ParadigmEngineering/igvc-2023-hardware/README.md

# igvc-2023-hardware
Intelligent Ground Vehicle Competition (Spring 2023) hardware for the Paradigm Engineering Student Group
