ParadigmEngineering/igvc-2023-hardware/hardware/ControlBoard/ControlBoard_Build_2023_04_23/ControlBoard.csv

Comment | Designator | Footprint | LCSC
1u | C1,C31,C34,C37,C40 | Capacitor_SMD:C_0805_2012Metric | C116352
22uF | C13 | Capacitor_SMD:C_0805_2012Metric | C128856
0.1u_DNP | C15,C16 | Capacitor_SMD:C_0805_2012Metric
10u_DNP | C2,C10 | Capacitor_SMD:C_0805_2012Metric
33uF | C26 | Capacitor_THT:CP_Radial_D8.0mm_P3.50mm | C441625
4.7u | C3 | Capacitor_SMD:C_0805_2012Metric | C87998
10n | C30 | Capacitor_SMD:C_0805_2012Metric | C2688117
10u | C4,C5,C8,C18 | Capacitor_SMD:C_0805_2012Metric | C237493
1uF | C6 | Capacitor_SMD:C_0805_2012Metric | C116352
0.1u | C7,C9,C11,C12,C14,C17,C19,C21,C22,C23,C24,C25,C27,C28,C29,C32,C33,C35,C36,C38,C39 | Capacitor_SMD:C_0805_2012Metric | C519981
SMAJ5.0CA | D1,D4,D6,D7,D8,D10 | Diode_SMD:D_SMA | C83324
S1G | D11 | Diode_SMD:D_SMA | C260339
RED | D2,D3 | LED_SMD:LED_0603_1608Metric | C160478
SL04-E3-08_DNP | D5,D9 | Diode_SMD:D_SMF | C5224083
M3 | H1,H2,H3,H4 | MountingHole:MountingHole_3.2mm_M3_Pad_Via
Lamp 1 Out | J1 | Connector_Molex:Molex_Micro-Fit_3.0_43650-0200_1x02_P3.00mm_Horizontal | C192562
CAN | J10 | Connector_JST:JST_PH_B4B-PH-K_1x04_P2.00mm_Vertical | C566011
Conn_01x02 | J12 | Connector_Molex:Molex_Micro-Fit_3.0_43650-0200_1x02_P3.00mm_Horizontal | C192562
Available GPIO_DNP | J13 | Connector_PinHeader_1.27mm:PinHeader_1x05_P1.27mm_Vertical
MOTOR_CTRL1 | J14 | Connector_Molex:Molex_Micro-Fit_3.0_43650-1000_1x10_P3.00mm_Horizontal
MOTOR_CTRL2 | J15 | Connector_Molex:Molex_Micro-Fit_3.0_43650-1000_1x10_P3.00mm_Horizontal
5V HEADER | J16 | Connector_Molex:Molex_KK-254_AE-6410-03A_1x03_P2.54mm_Vertical | C471416
ESTOP1 | J2 | Connector_Molex:Molex_Micro-Fit_3.0_43650-0200_1x02_P3.00mm_Horizontal | C192562
ESTOP2 | J3 | Connector_JST:JST_PH_B4B-PH-K_1x04_P2.00mm_Vertical | C566011
Lamp 3 Out | J4 | Connector_Molex:Molex_Micro-Fit_3.0_43650-0200_1x02_P3.00mm_Horizontal | C192562
Lamp 2 Out | J5 | Connector_Molex:Molex_Micro-Fit_3.0_43650-0200_1x02_P3.00mm_Horizontal | C192562
Lamp 4 Out | J6 | Connector_Molex:Molex_Micro-Fit_3.0_43650-0200_1x02_P3.00mm_Horizontal | C192562
PWR_IN | J7 | Connector_Molex:Molex_Micro-Fit_3.0_43650-0200_1x02_P3.00mm_Horizontal | C192562
USB_B_Micro | J8,J11 | Connector_USB:USB_Micro-B_Amphenol_10118194_Horizontal | C132563
UART BACKUP | J9 | Connector_PinHeader_2.54mm:PinHeader_1x04_P2.54mm_Vertical
DMN62D0U-13 | Q1,Q2,Q3,Q4 | controlLib:DMN62D0U-13 | C156342
SS8050-G | Q5 | controlLib:TRANS_SS8050-G | C164886
SS8050-G | Q6 | TRANS_SS8050-G | C164886
1k | R1,R2,R3,R6,R7,R8,R36,R37,R38,R39,R40,R41,R42,R43,R70,R71 | Resistor_SMD:R_0805_2012Metric | C510097
10k_DNP | R11 | Resistor_SMD:R_0805_2012Metric
10k | R12,R13,R18,R61,R67 | Resistor_SMD:R_0805_2012Metric | C110775
0_DNP | R16,R17,R19,R27,R28,R30,R31,R44,R45,R50,R60,R62,R64,R65,R66,R68,R77,R78 | Resistor_SMD:R_0805_2012Metric
220 | R32,R33,R49,R52 | Resistor_SMD:R_0805_2012Metric | C114519
22.1K | R4 | Resistor_SMD:R_0805_2012Metric | C273840
330 | R46,R47 | Resistor_SMD:R_0805_2012Metric | C105878
120 | R48 | Resistor_SMD:R_0805_2012Metric | C114245
47.5K | R5 | Resistor_SMD:R_0805_2012Metric | C137519
1.15k | R54,R55 | Resistor_SMD:R_0805_2012Metric | C309566
2k | R56 | Resistor_SMD:R_0805_2012Metric | C127985
4.7k_DNP | R57,R58,R59 | Resistor_SMD:R_0805_2012Metric
0 | R9,R10,R14,R15,R20,R21,R22,R23,R24,R25,R26,R29,R34,R35,R51,R53,R63,R69,R72,R74,R75,R76 | Resistor_SMD:R_0805_2012Metric | C237773
SW_Push | SW1,SW2 | Button_Switch_SMD:SW_SPST_B3U-1100P-B
TestPoint | TP1,TP2,TP3,TP4,TP5,TP6 | TestPoint:TestPoint_Pad_D1.0mm
CP2102N-A02-GQFN28 | U1 | Package_DFN_QFN:QFN-28-1EP_5x5mm_P0.5mm_EP3.35x3.35mm | C964632
74LVC1G17W5-7 | U10,U11 | controlLib:74LVC1G17W5-7 | C151394
Lora_Module | U2 | controlLib:Lora_Module
R-78B5.0-2.0 | U3 | controlLib:R-78B5.0-2.0
LD1086V33-DG | U4 | Package_TO_SOT_THT:TO-220-3_Vertical
ESP32-S3-WROOM-1U-N16 | U5 | XCVR_ESP32-S3-WROOM-1U | C2980298
74LVC1G97W6-7 | U6 | controlLib:74LVC1G97W6-7
SN65HVD232 | U7 | Package_SO:SOIC-8_3.9x4.9mm_P1.27mm | C30530
SN74LVC1GU04DBVR | U8 | Package_TO_SOT_SMD:SOT-23-5 | C81934
TXU0104QPWRQ1 | U9,U12 | controlLib:TXU0104QPWRQ1
