ParadigmEngineering/igvc-2023-hardware/hardware/ControlBoard/3D_lib/R-78B-2.0.STEP

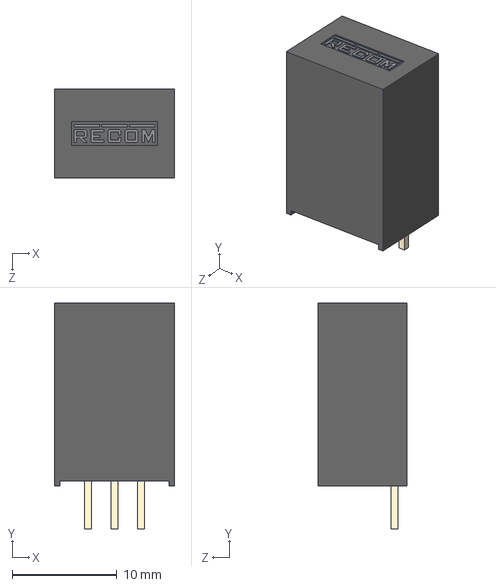
[picture p1: CAD file, 2023-04-20]
hardware/ControlBoard/3D_lib/R-78B-2.0.STEP
11.5 x 21.6 x 8.50 mm
