ParadigmEngineering/igvc-2023-hardware/hardware/PowerDistributionBoard/PowerDistributionBoard/Parts/3D Models/SO-8_S_LIT.step

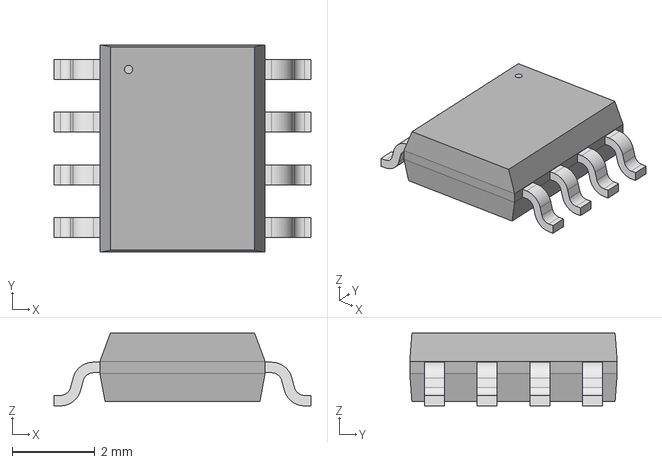
[picture p2: CAD file, 2023-04-21]
hardware/PowerDistributionBoard/PowerDistributionBoard/Parts/3D Models/SO-8_S_LIT.step
6.20 x 5.00 x 1.75 mm
