ParadigmEngineering/igvc-2023-hardware/hardware/PowerDistributionBoard/PowerDistributionBoard/Parts/MAX6643LBBAEET.step

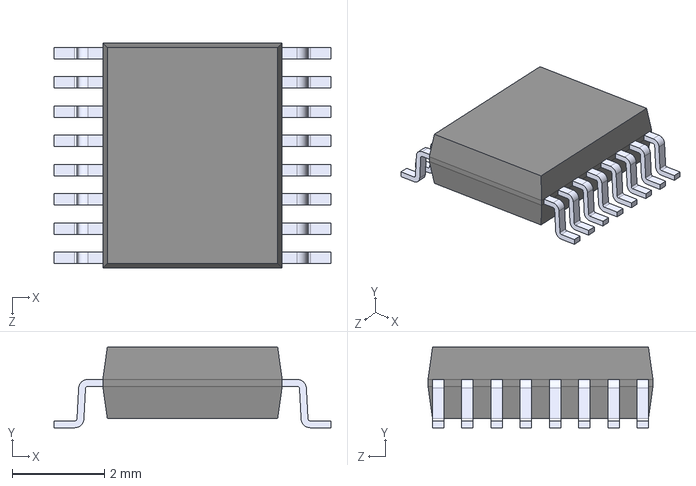
[picture p3: CAD file, 2023-01-04]
hardware/PowerDistributionBoard/PowerDistributionBoard/Parts/MAX6643LBBAEET.step
6.02 x 1.75 x 4.89 mm
