ParadigmEngineering/igvc-2023-hardware/hardware/EStopTX/EStopTX/Parts/3d models/A11AH.stp

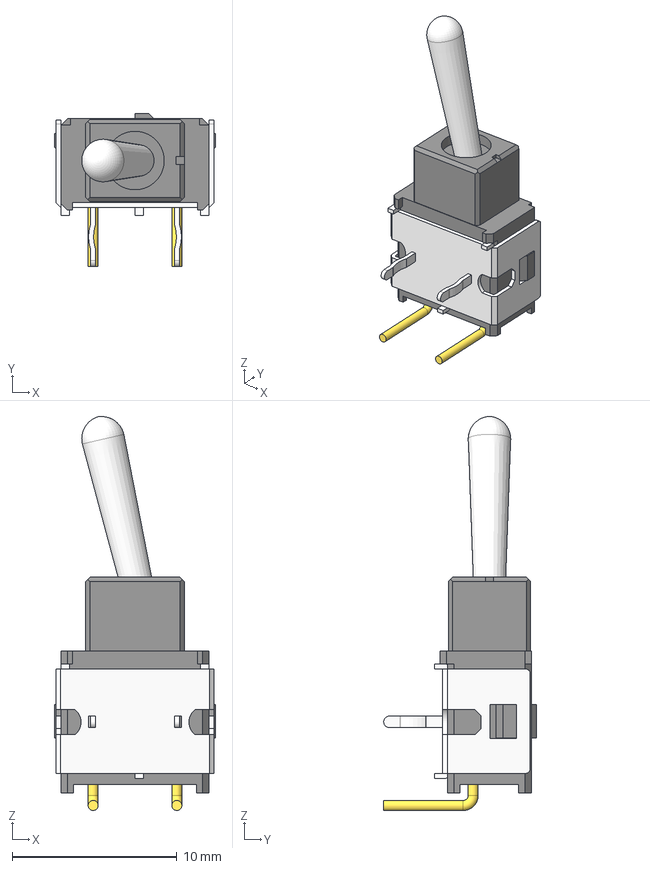
[picture p4: CAD file, 2023-04-11]
hardware/EStopTX/EStopTX/Parts/3d models/A11AH.stp
9.80 x 9.27 x 23.9 mm
AA-toggle-toggle
A1H-toggle-bracket_ra
A11H-toggle-terminals
A1-toggle-body
