ParadigmEngineering/igvc-2023-hardware/hardware/ControlBoard/3D_lib/TRAN_SS8050-G_CIP.step

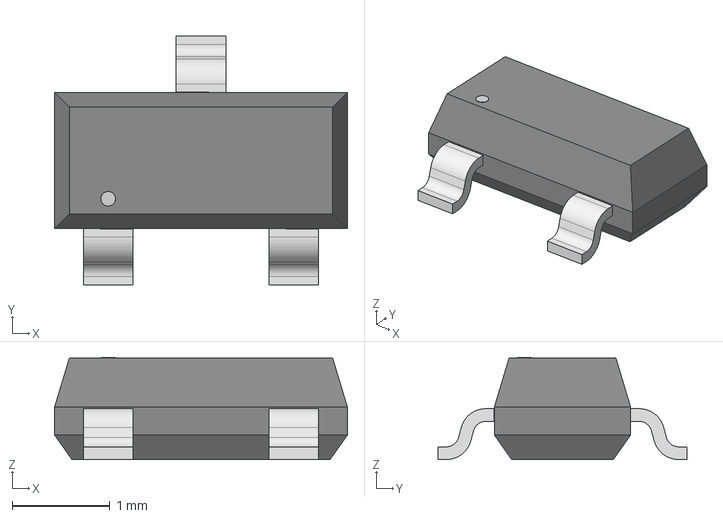
[picture p5: CAD file, 2023-04-11]
hardware/ControlBoard/3D_lib/TRAN_SS8050-G_CIP.step
3.00 x 2.55 x 1.04 mm
