ParadigmEngineering/igvc-2023-hardware/hardware/EStopTX/EStopTX/Parts/3d models/USB-B1HSB6--3DModel-STEP-1 (1).STEP

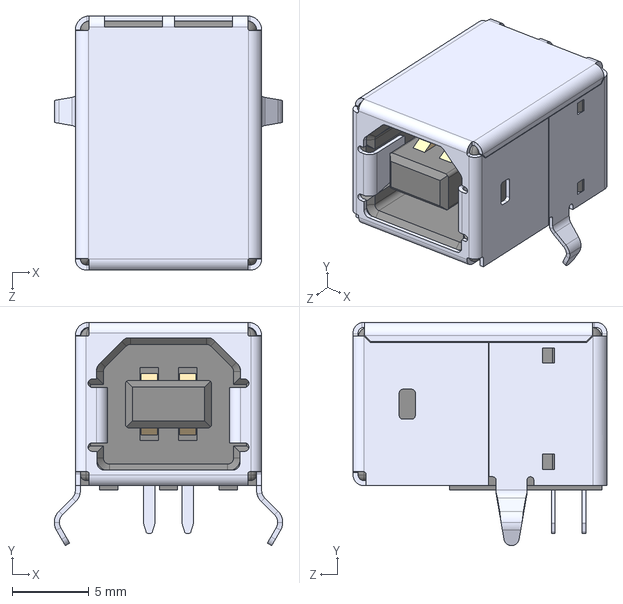
[picture p6: CAD file, 2023-04-04]
hardware/EStopTX/EStopTX/Parts/3d models/USB-B1HSB6--3DModel-STEP-1 (1).STEP
14.8 x 14.5 x 16.5 mm
