ParadigmEngineering/igvc-2023-hardware/hardware/PowerDistributionBoard/PowerDistributionBoard/Parts/3D Models/3557-2--3DModel-STEP-510211.STEP

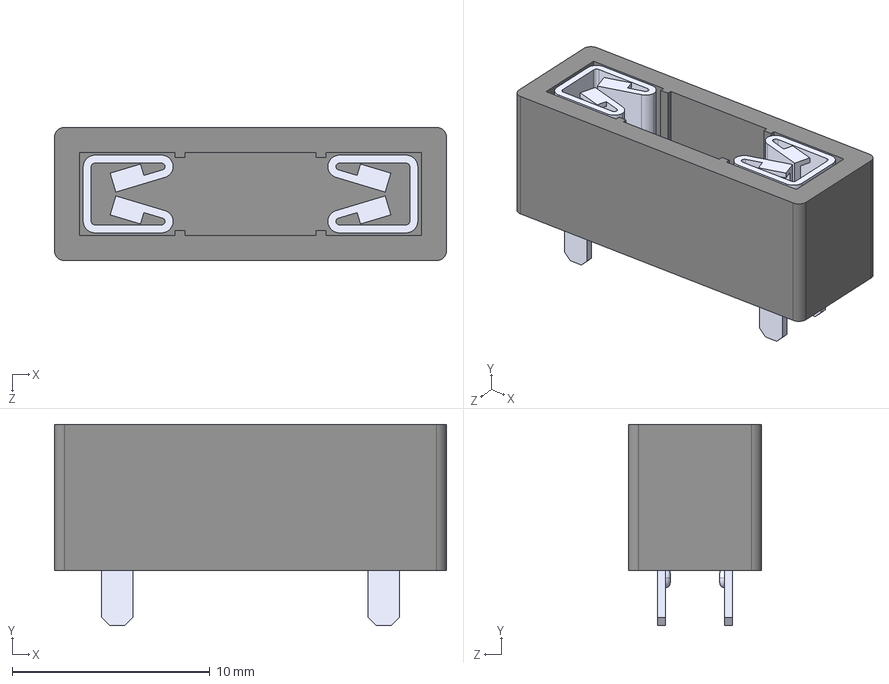
[picture p7: CAD file, 2023-04-16]
hardware/PowerDistributionBoard/PowerDistributionBoard/Parts/3D Models/3557-2--3DModel-STEP-510211.STEP
19.8 x 10.2 x 6.73 mm
