ParadigmEngineering/igvc-2023-hardware/hardware/ControlBoard/3D_lib/74LVC1G17W5-7.STEP

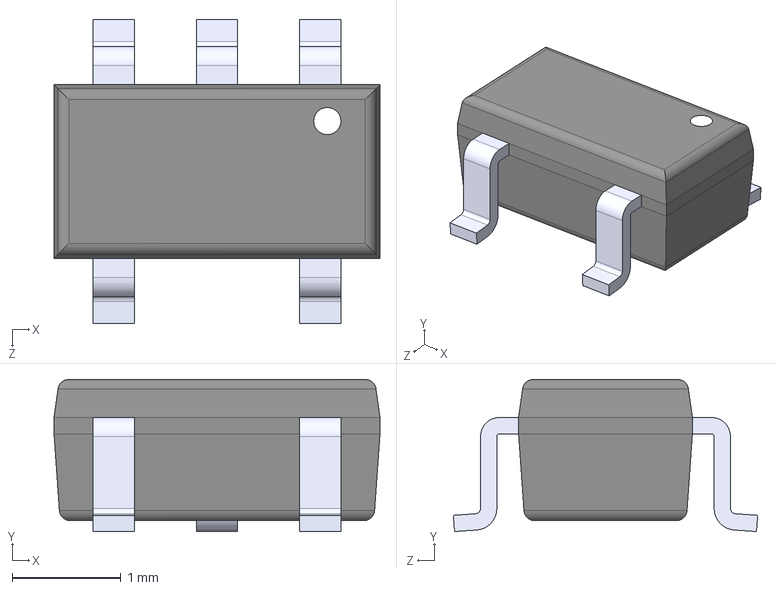
[picture p8: CAD file, 2023-04-09]
hardware/ControlBoard/3D_lib/74LVC1G17W5-7.STEP
3.00 x 1.40 x 2.80 mm
