ParadigmEngineering/igvc-2023-hardware/hardware/ControlBoard/3D_lib/SOT23_DMN62D0U_DIO.step

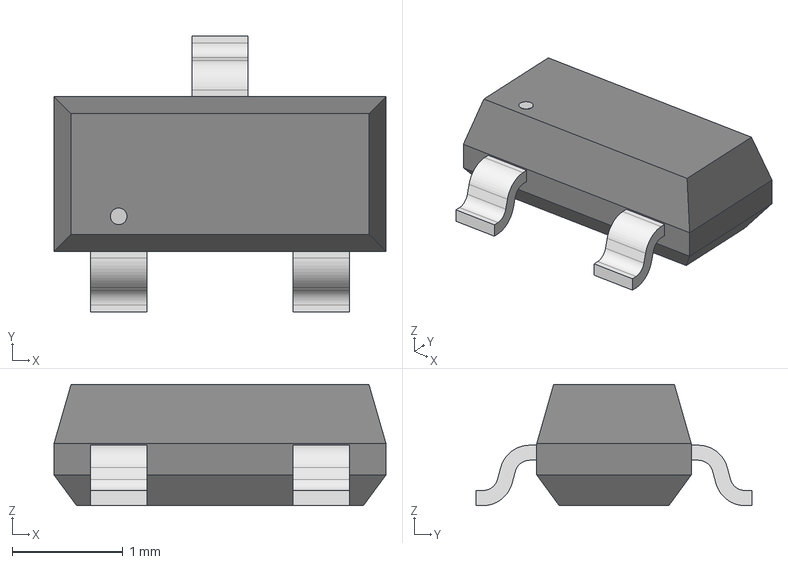
[picture p9: CAD file, 2023-04-09]
hardware/ControlBoard/3D_lib/SOT23_DMN62D0U_DIO.step
3.00 x 2.49 x 1.09 mm
