ParadigmEngineering/igvc-2023-hardware/hardware/ControlBoard/3D_lib/PW0014A.stp

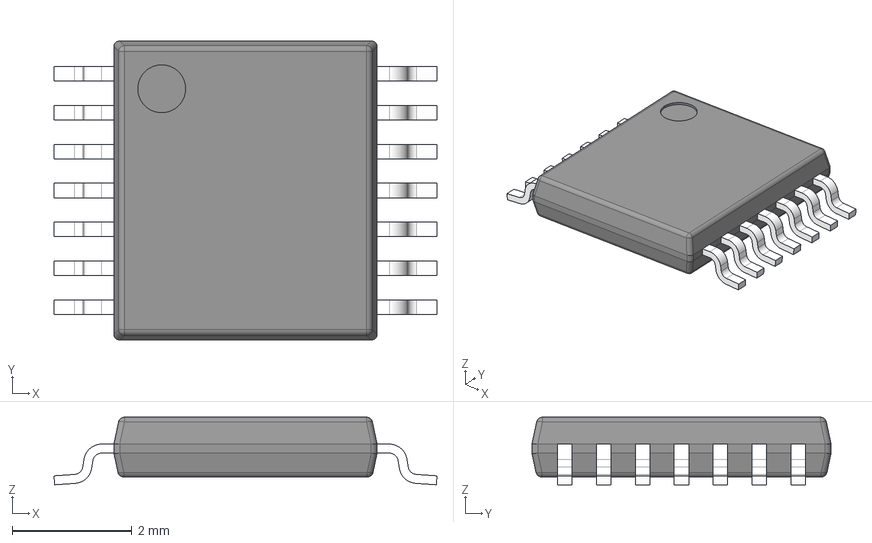
[picture p10: CAD file, 2023-04-09]
hardware/ControlBoard/3D_lib/PW0014A.stp
6.40 x 5.00 x 1.13 mm
BODY-TSSOP
LEAD-TSSOP x 14
PIN1
