ParadigmEngineering/igvc-2023-hardware/hardware/PowerDistributionBoard/PowerDistributionBoard/Parts/3D Models/EG1218--3DModel-STEP-520916.STEP

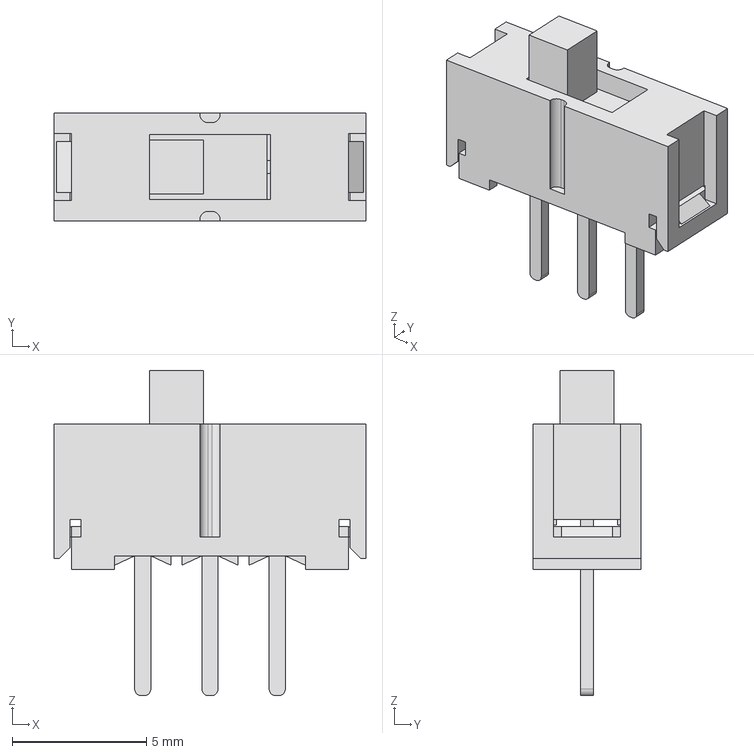
[picture p11: CAD file, 2023-02-03]
hardware/PowerDistributionBoard/PowerDistributionBoard/Parts/3D Models/EG1218--3DModel-STEP-520916.STEP
11.6 x 4.00 x 12.1 mm
