ParadigmEngineering/igvc-2023-hardware/hardware/ControlBoard/3D_lib/74LVC1G97W6-7.STEP

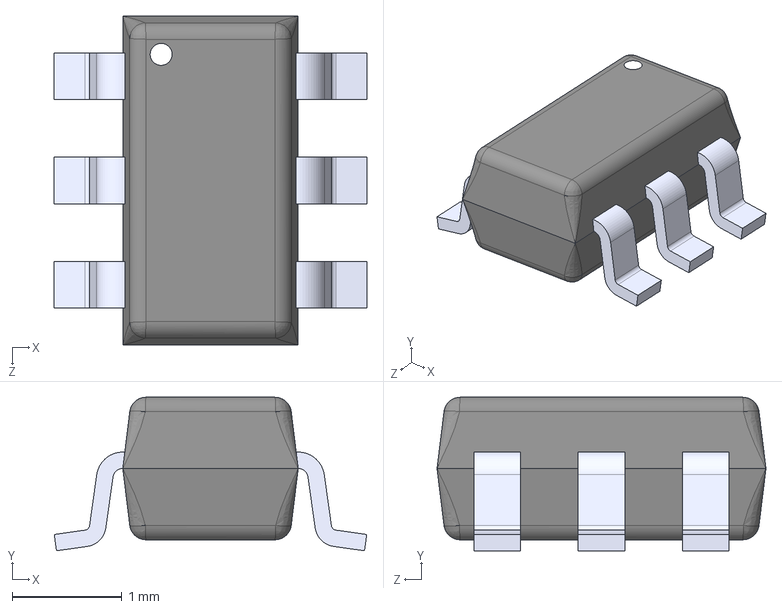
[picture p12: CAD file, 2023-03-25]
hardware/ControlBoard/3D_lib/74LVC1G97W6-7.STEP
2.85 x 1.40 x 3.00 mm
