ParadigmEngineering/igvc-2023-hardware/hardware/ControlBoard/3D_lib/ESP32-S3-WROOM-1U--3DModel-STEP-56544.STEP

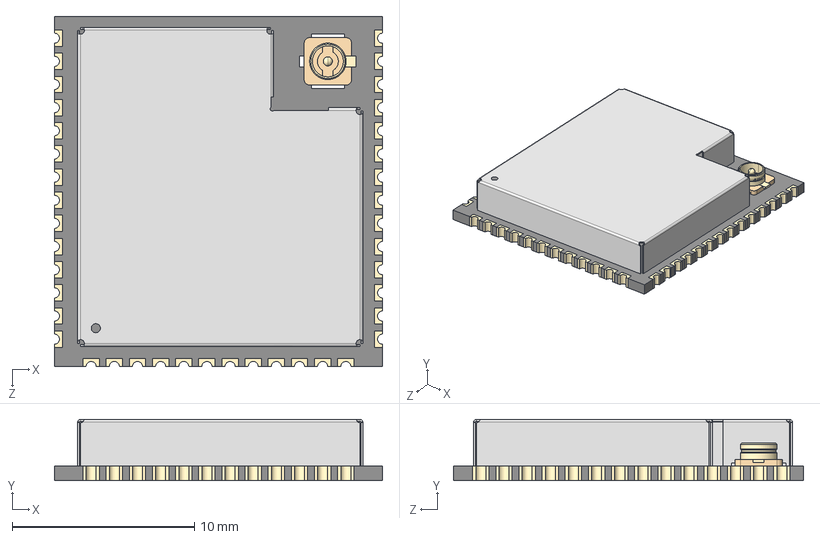
[picture p13: CAD file, 2023-03-25]
hardware/ControlBoard/3D_lib/ESP32-S3-WROOM-1U--3DModel-STEP-56544.STEP
18.0 x 3.35 x 19.2 mm
