ParadigmEngineering/igvc-2023-hardware/hardware/ControlBoard/3D_lib/SOT223-5_DIO.step

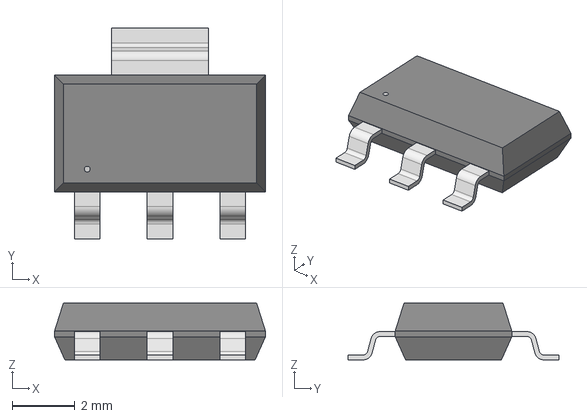
[picture p14: CAD file, 2023-03-25]
hardware/ControlBoard/3D_lib/SOT223-5_DIO.step
6.71 x 6.71 x 1.81 mm
