ParadigmEngineering/igvc-2023-hardware/hardware/ControlBoard/3D_lib/LD1086DT33TR.STEP

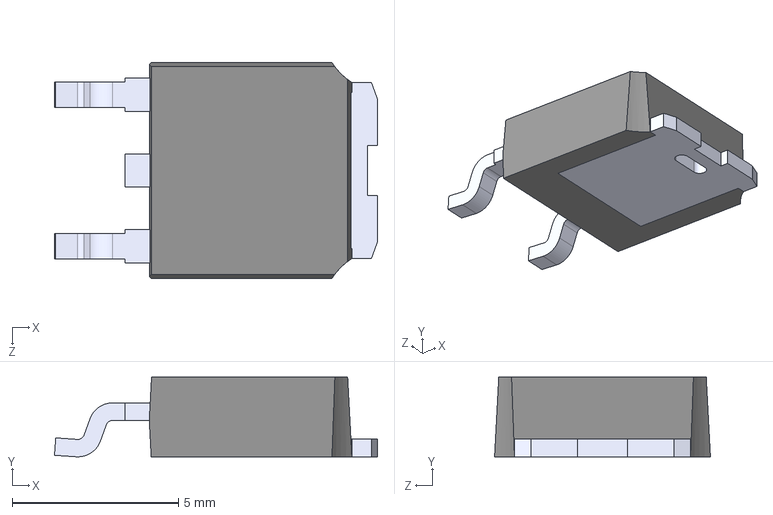
[picture p15: CAD file, 2023-03-25]
hardware/ControlBoard/3D_lib/LD1086DT33TR.STEP
9.72 x 2.40 x 6.50 mm
