ParadigmEngineering/igvc-2023-hardware/hardware/ControlBoard/3D_lib/PW0016A.stp

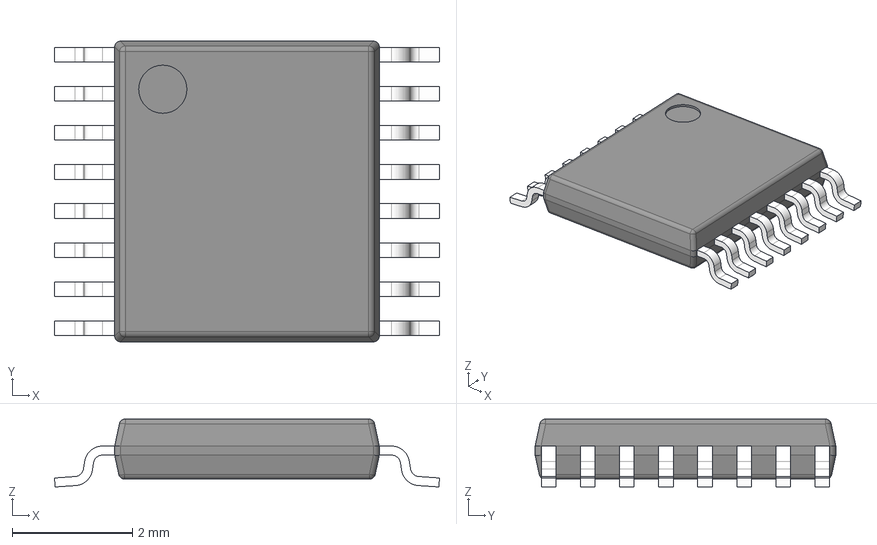
[picture p16: CAD file, 2023-03-24]
hardware/ControlBoard/3D_lib/PW0016A.stp
6.40 x 5.00 x 1.13 mm
BODY-TSSOP
LEAD-TSSOP x 16
PIN1
