ParadigmEngineering/igvc-2023-hardware/hardware/ControlBoard/3D_lib/B3SL-1022P--3DModel-STEP-1.STEP

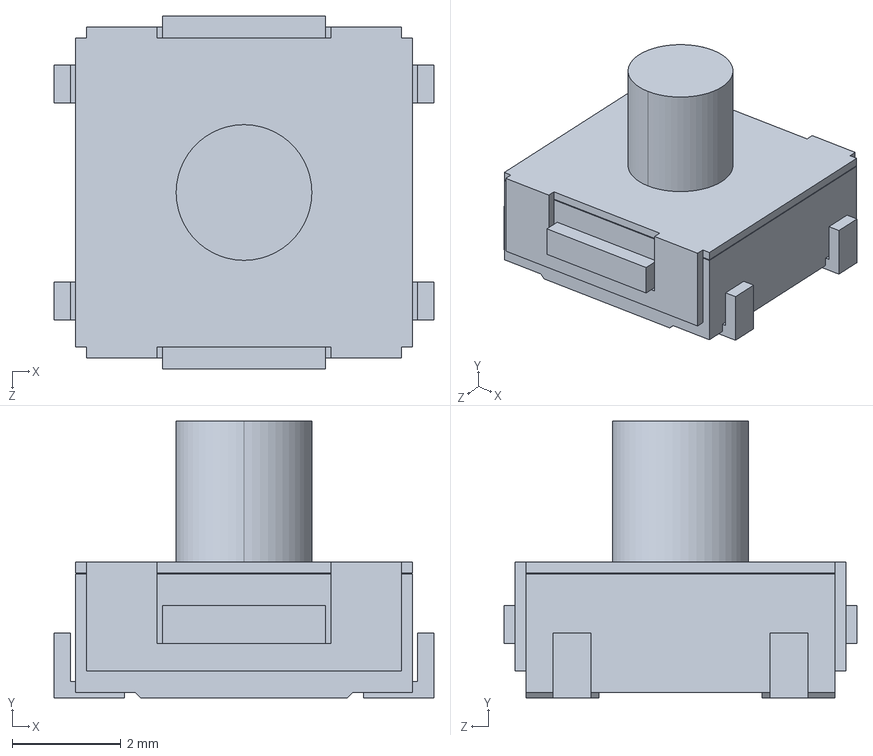
[picture p17: CAD file, 2023-02-03]
hardware/ControlBoard/3D_lib/B3SL-1022P--3DModel-STEP-1.STEP
7.00 x 5.10 x 6.50 mm
