ParadigmEngineering/igvc-2023-hardware/(list of files, cad)

Other CAD files:
hardware/PowerDistributionBoard/PowerDistributionBoard/Parts/3D Models/R-78B-1.0.step
hardware/ControlBoard/3D_lib/10118194c.stp
hardware/ControlBoard/3D_lib/1050170001.stp
hardware/ControlBoard/3D_lib/428202224.stp
hardware/ControlBoard/3D_lib/436500201_m.stp
hardware/ControlBoard/3D_lib/436501000.stp
hardware/ControlBoard/3D_lib/54602-908LFc.stp
hardware/ControlBoard/3D_lib/577102B00000G.stp
hardware/EStopTX/EStopTX/Parts/3d models/436500200--3DModel-STEP-390490.STEP
hardware/EStopTX/EStopTX/Parts/3d models/L102021ML04Q--3DModel-STEP-56544.STEP
hardware/PowerDistributionBoard/PowerDistributionBoard/Parts/3D Models/0679L1000-05.STEP
hardware/PowerDistributionBoard/PowerDistributionBoard/Parts/3D Models/428202223--3DModel-STEP-390490.STEP
hardware/PowerDistributionBoard/PowerDistributionBoard/Parts/3D Models/436500215.stp
hardware/PowerDistributionBoard/PowerDistributionBoard/Parts/3D Models/577102B00000G.stp
