ParadigmEngineering/igvc-2023-hardware/hardware/ControlBoard/ControlBrd_Review_SCH_V0_4.pdf

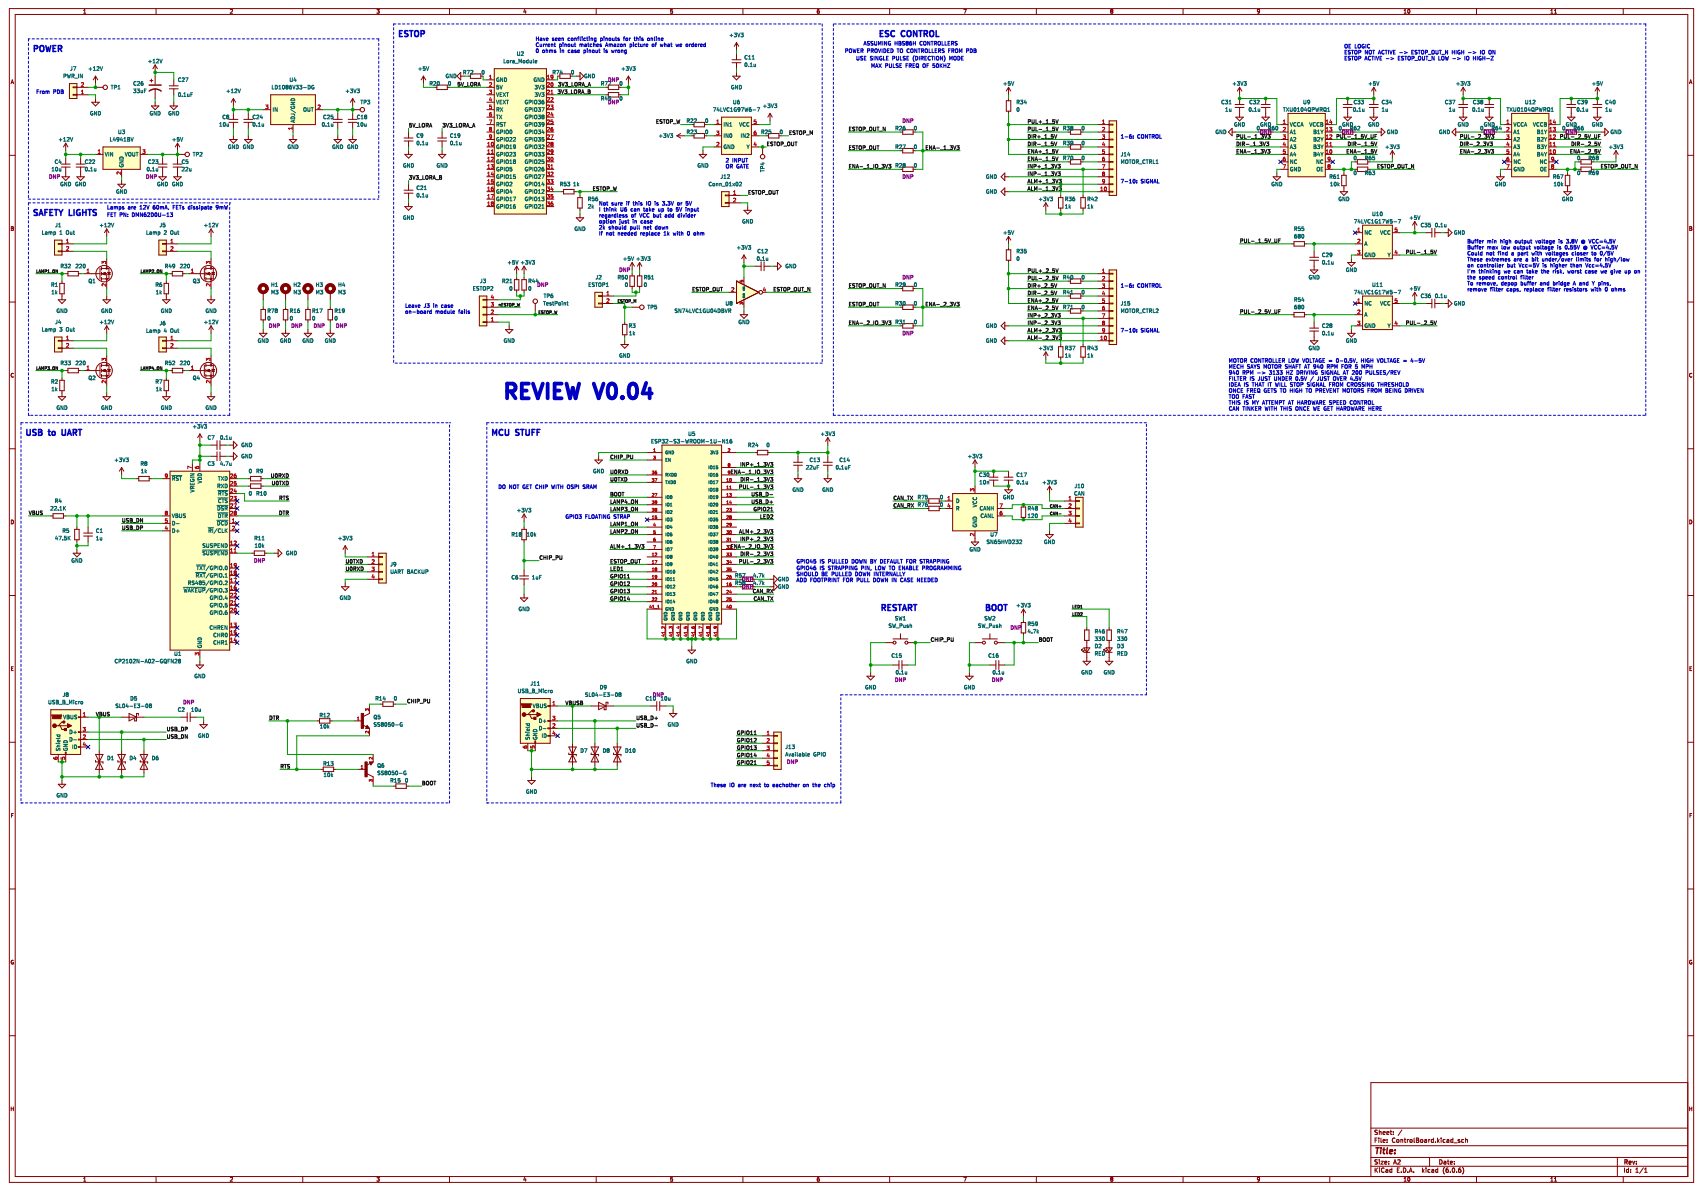
[picture p18: page 1]
