ParadigmEngineering/igvc-2023-hardware/hardware/PowerDistributionBoard/PDB_Review_SCH_V0_2.pdf

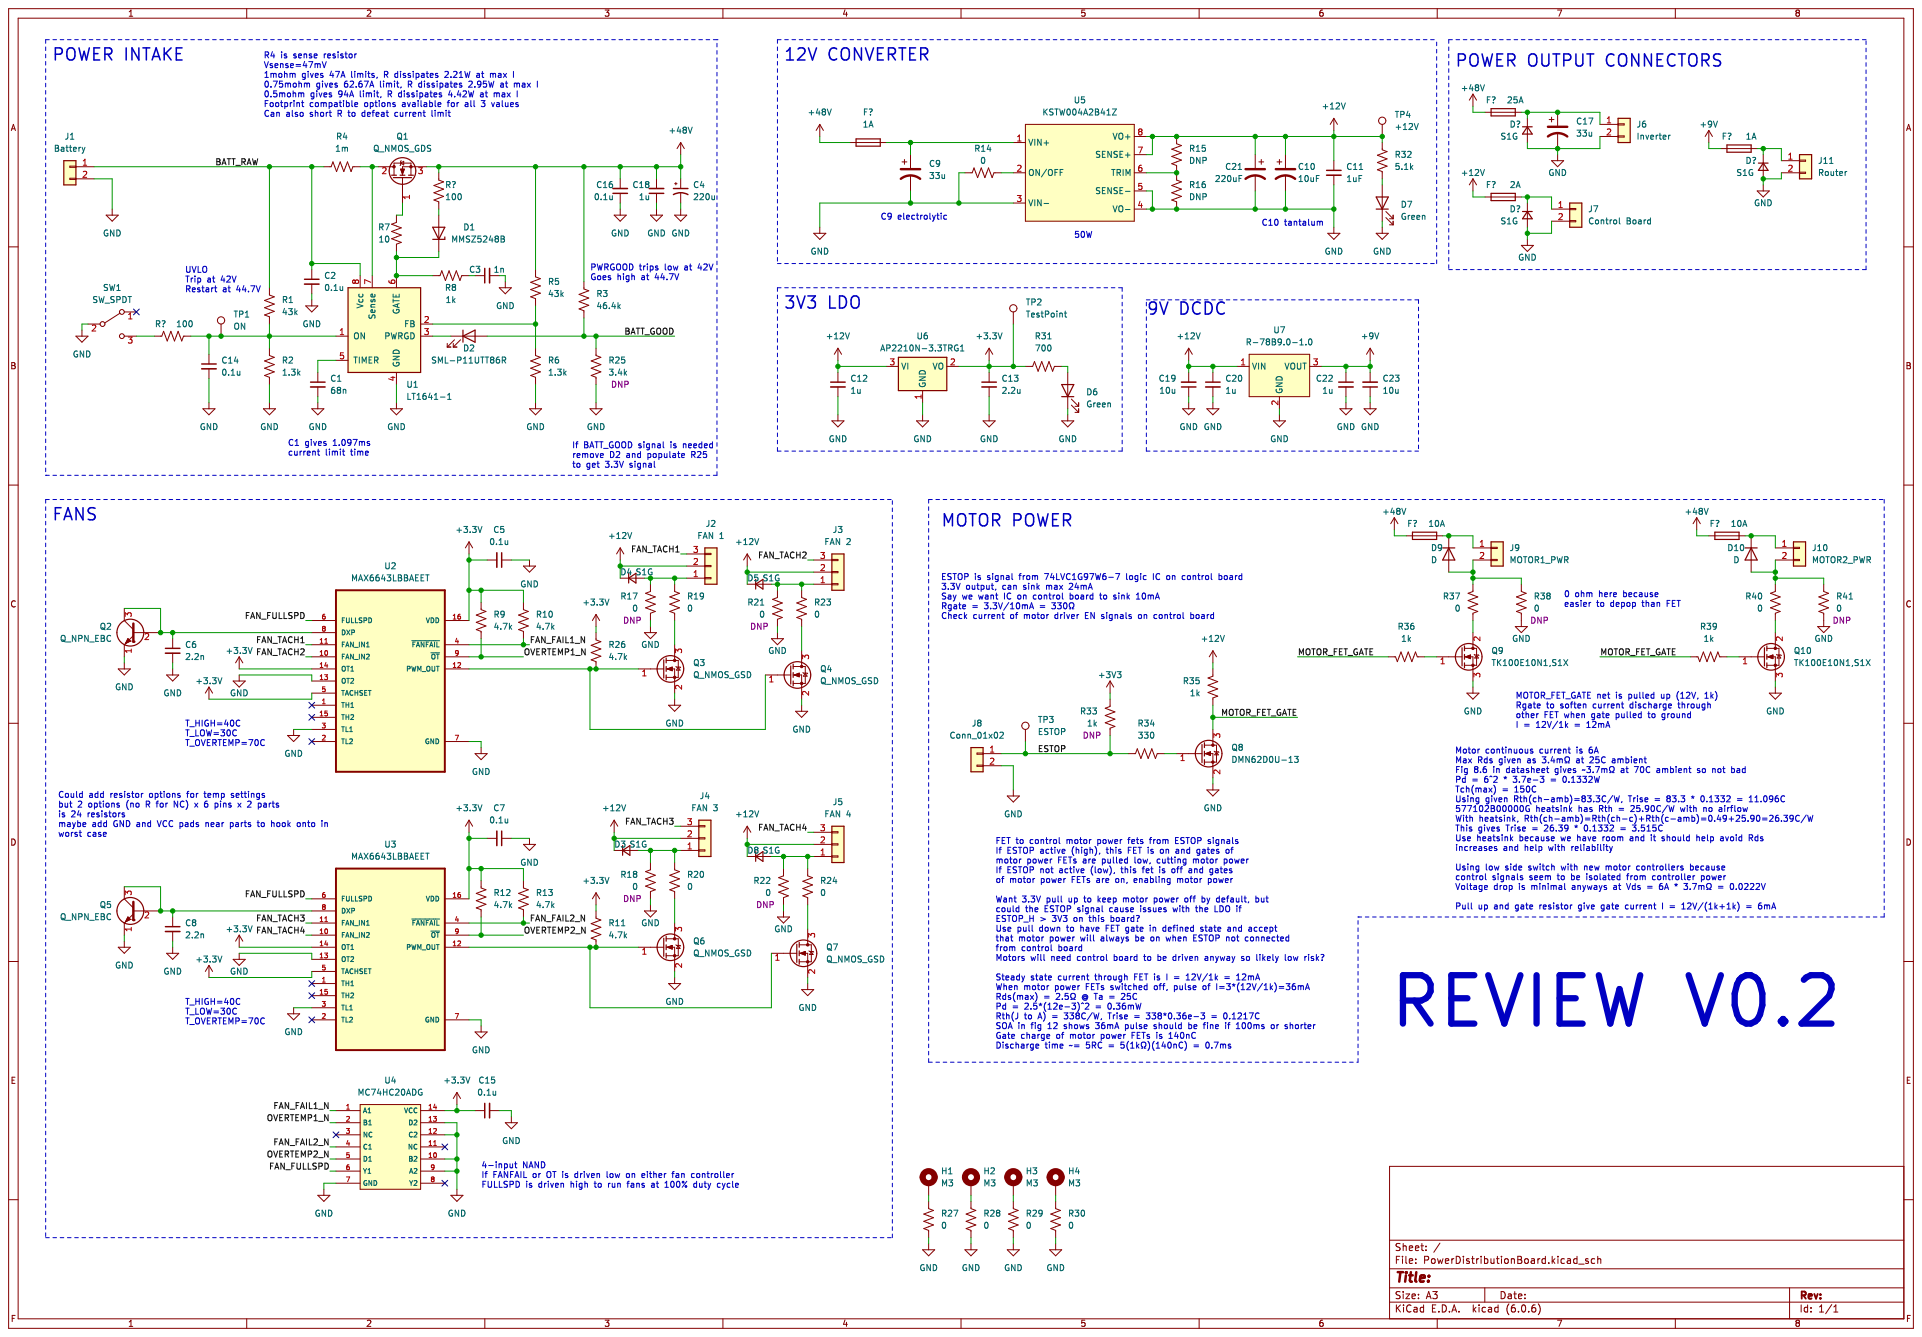
[picture p19: page 1]
