ParadigmEngineering/igvc-2023-hardware/hardware/ControlBoard/ControlBrd_Review_SCH_V0_3.pdf

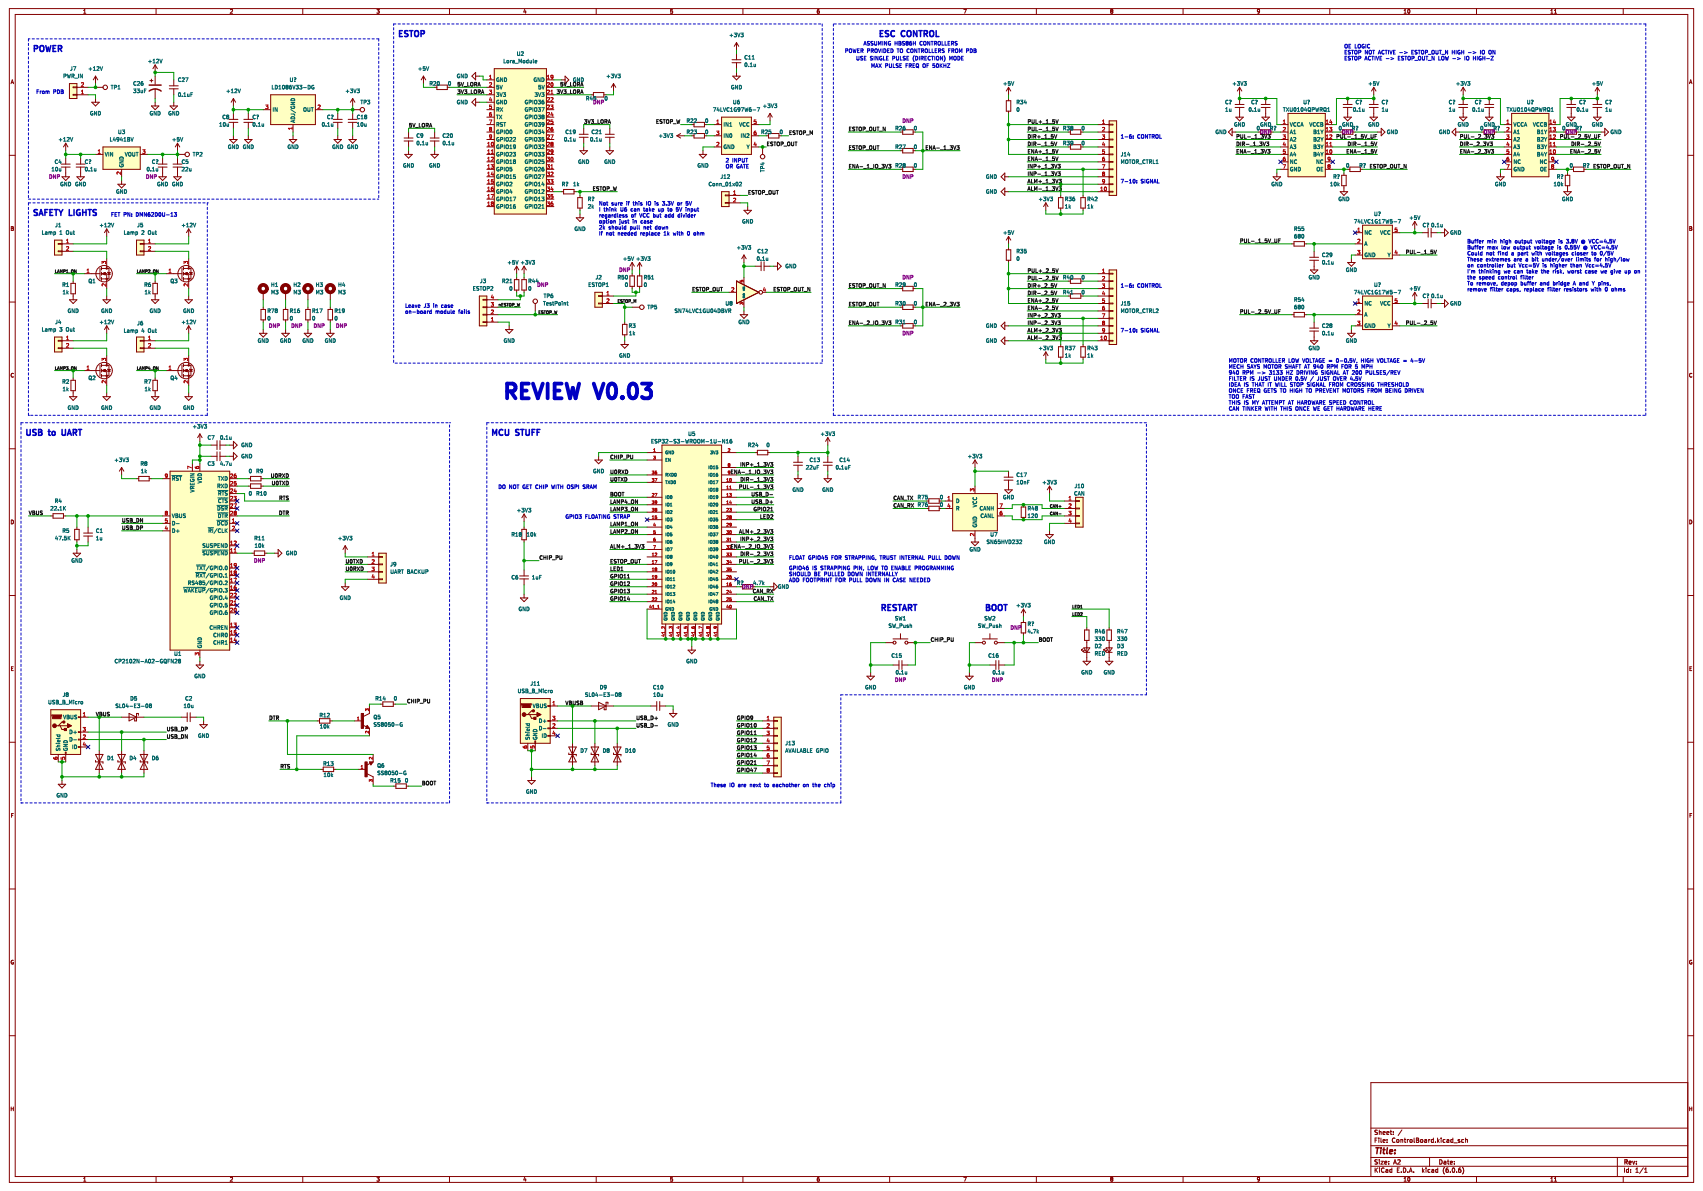
[picture p20: page 1]
