ParadigmEngineering/igvc-2023-hardware/hardware/ControlBoard/ControlBrd_Review_SCH_V0_2.pdf

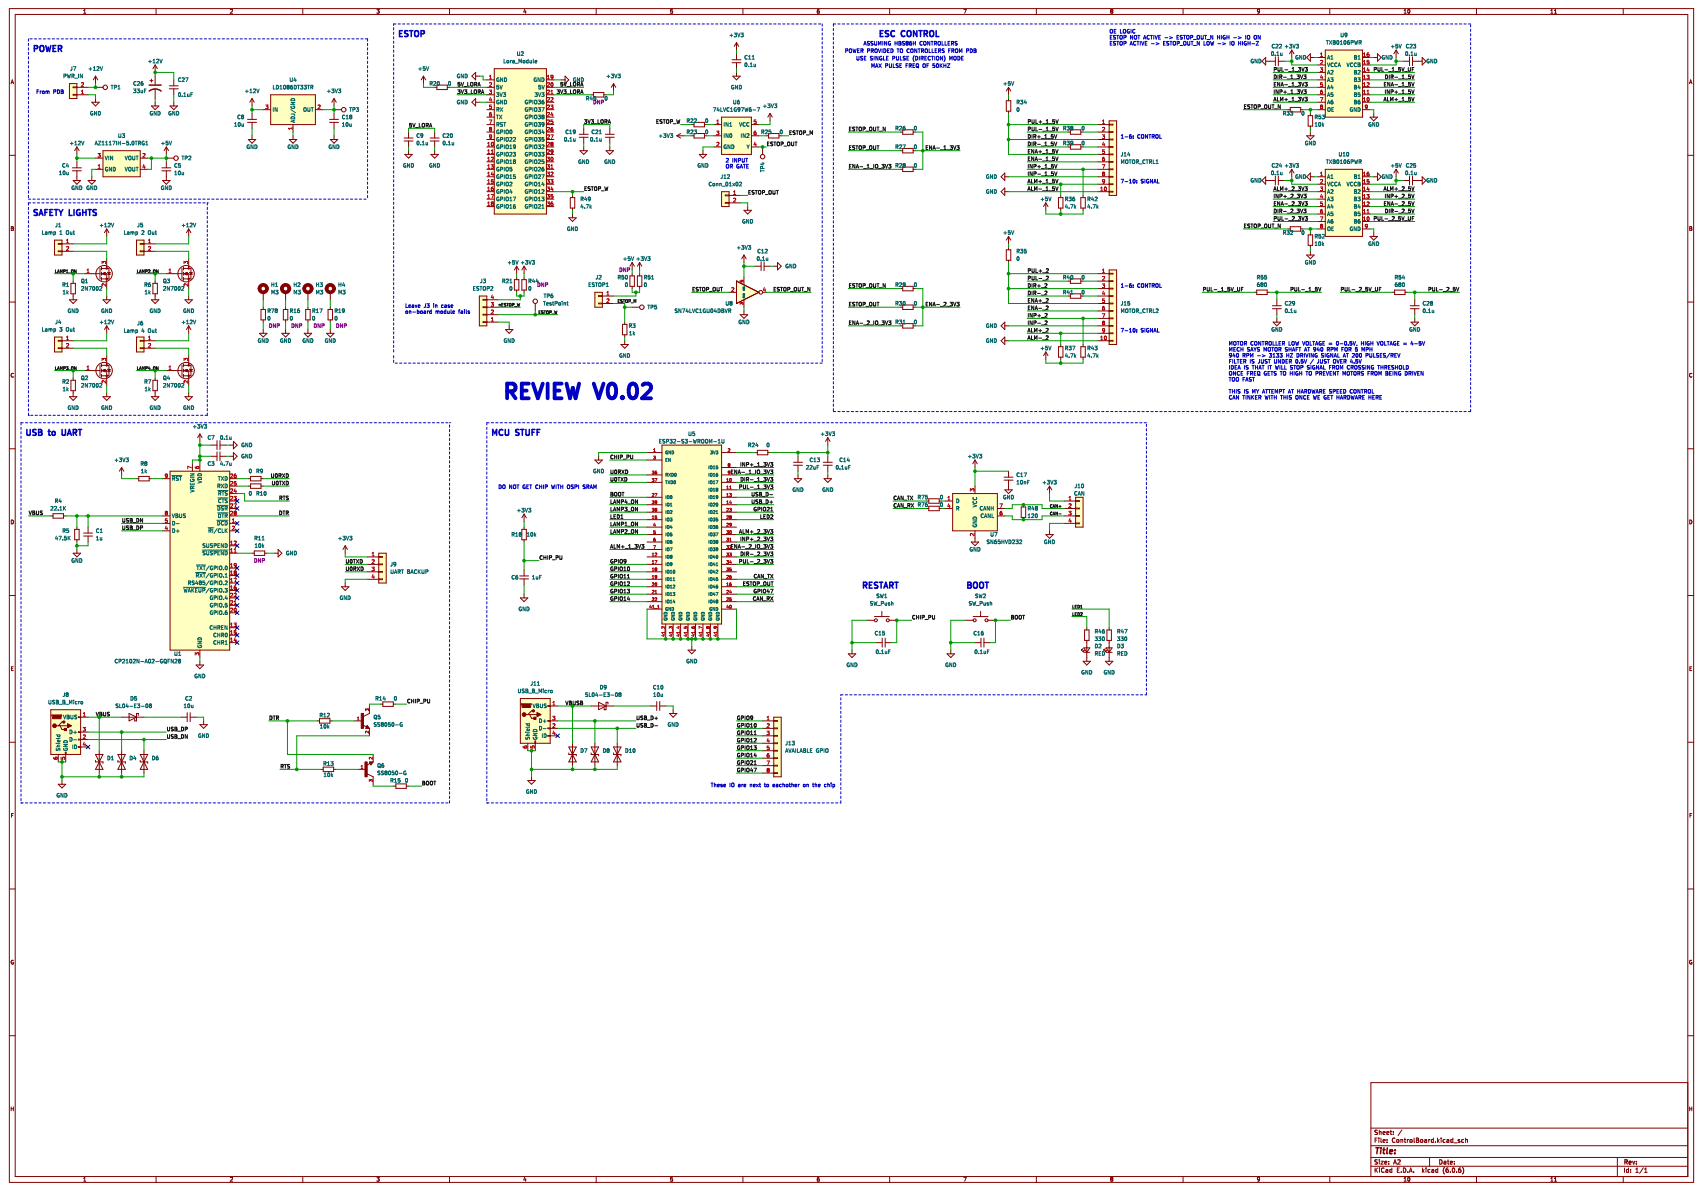
[picture p21: page 1]
