ParadigmEngineering/igvc-2023-hardware/hardware/ControlBoard/ControlBrd_Review_SCH_V0_1.pdf

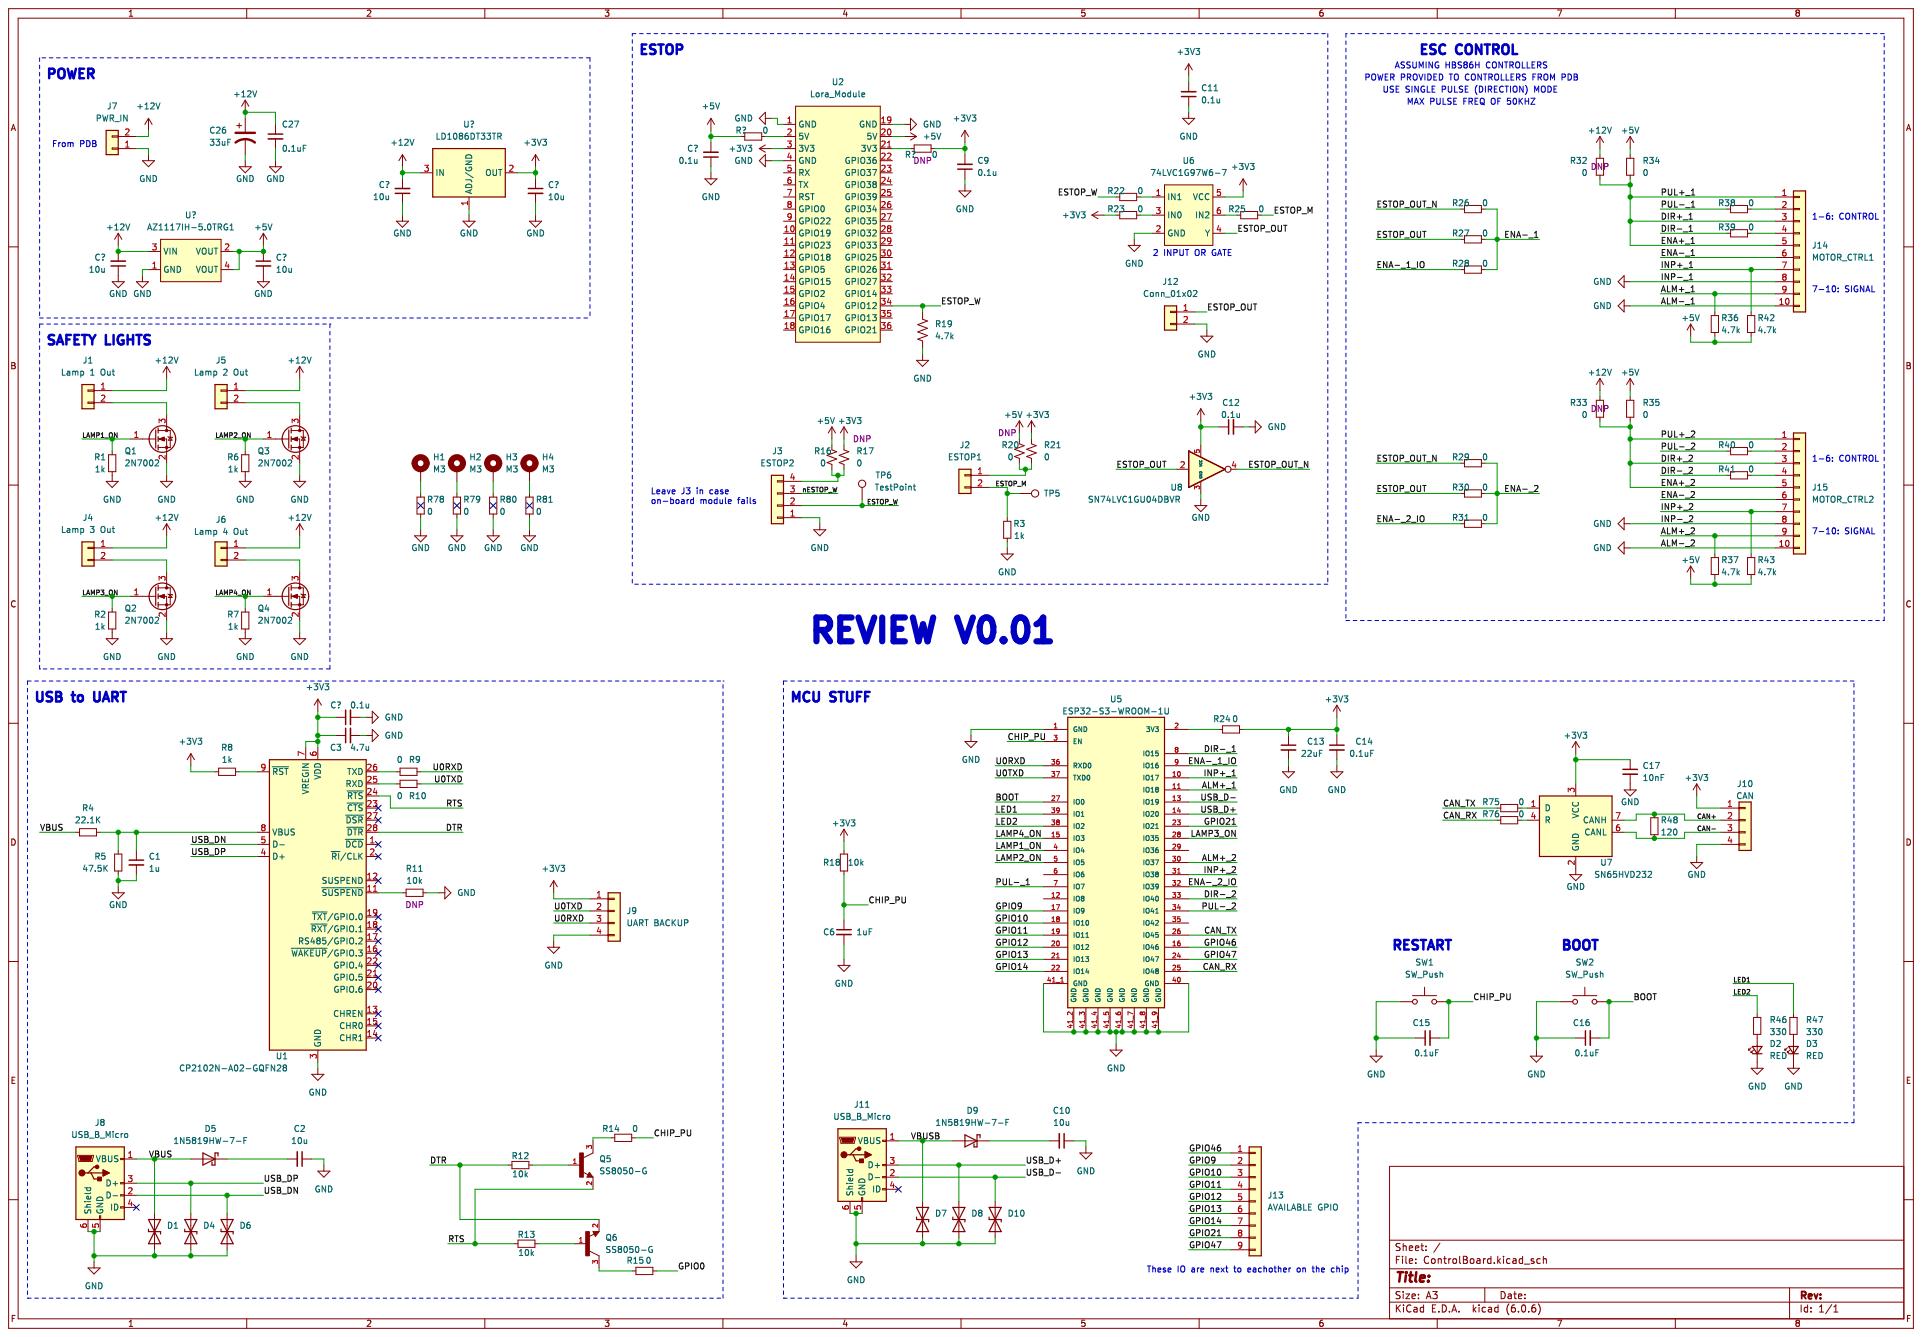
[picture p22: page 1]
