ParadigmEngineering/igvc-2023-hardware/hardware/PowerDistributionBoard/PDB_Review_SCH_V0_1.pdf

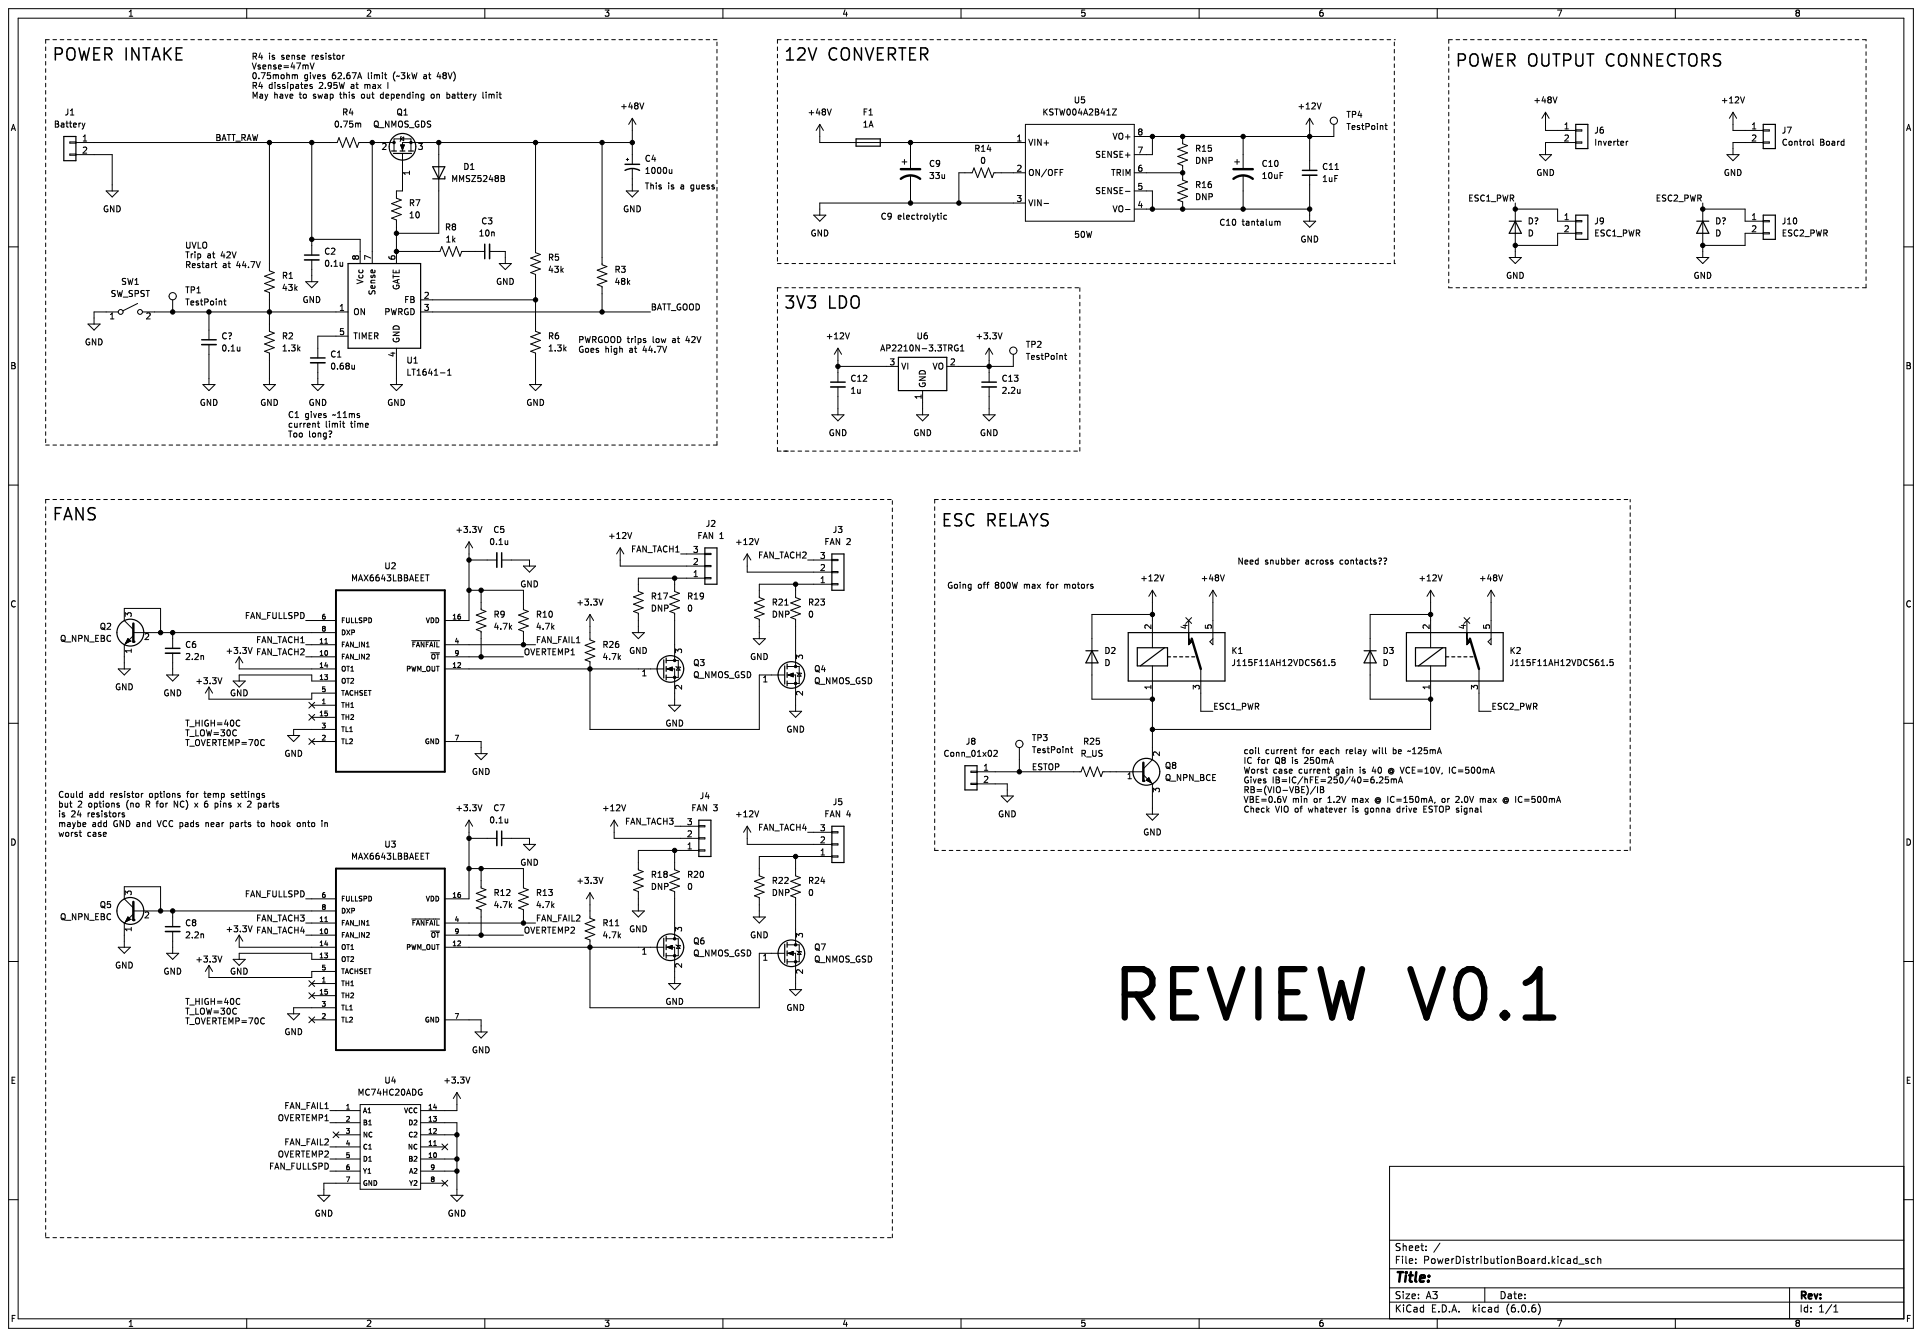
[picture p23: page 1]
