ParadigmEngineering/igvc-2023-hardware/hardware/ControlBoard/ControlBoard.kicad_pcb

## KiCad design hardware/ControlBoard/ControlBoard.kicad_pcb (2023-04-26)

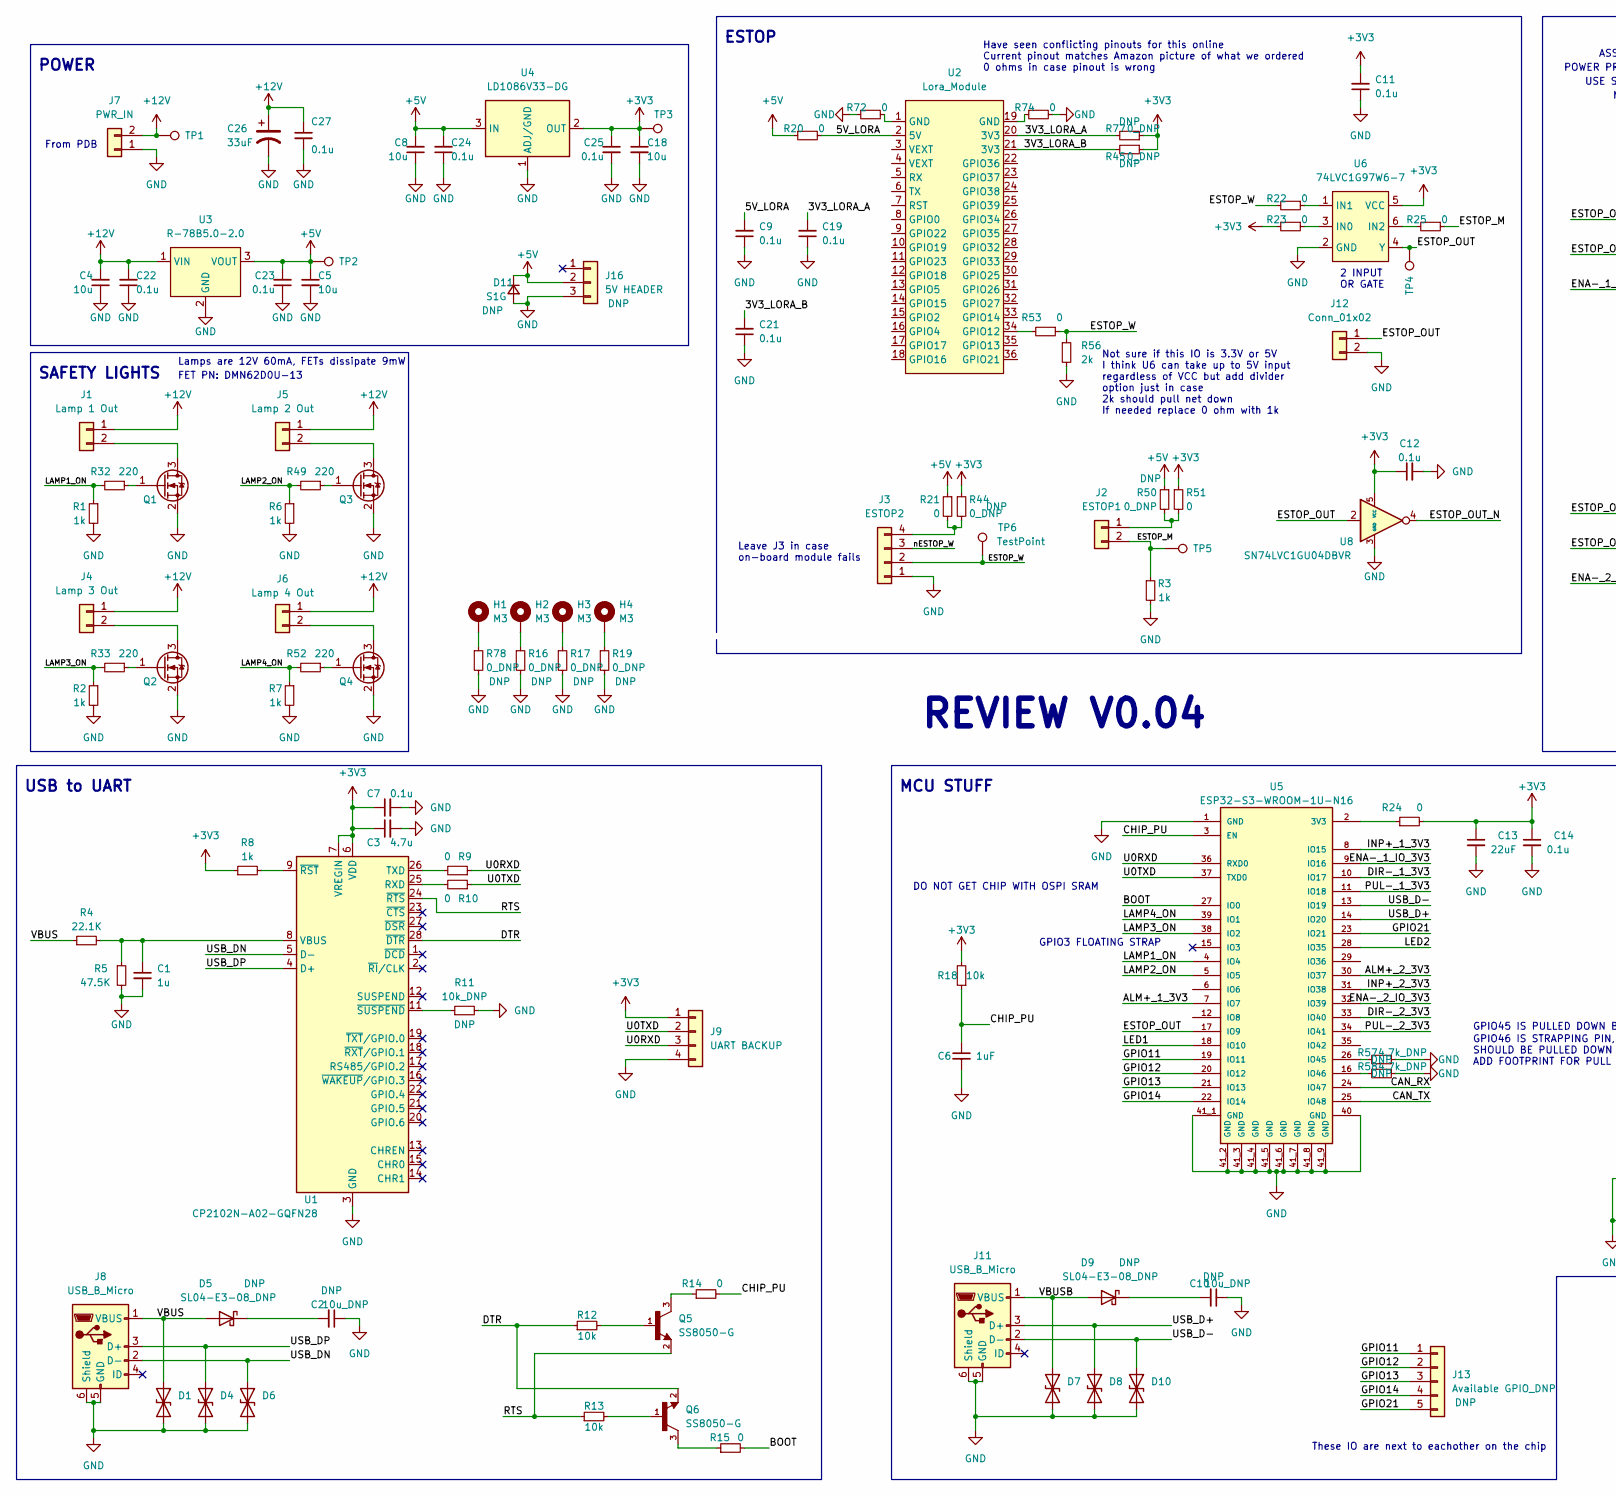
[picture p24: schematic ControlBoard.kicad_sch, part in row 1, column 1]

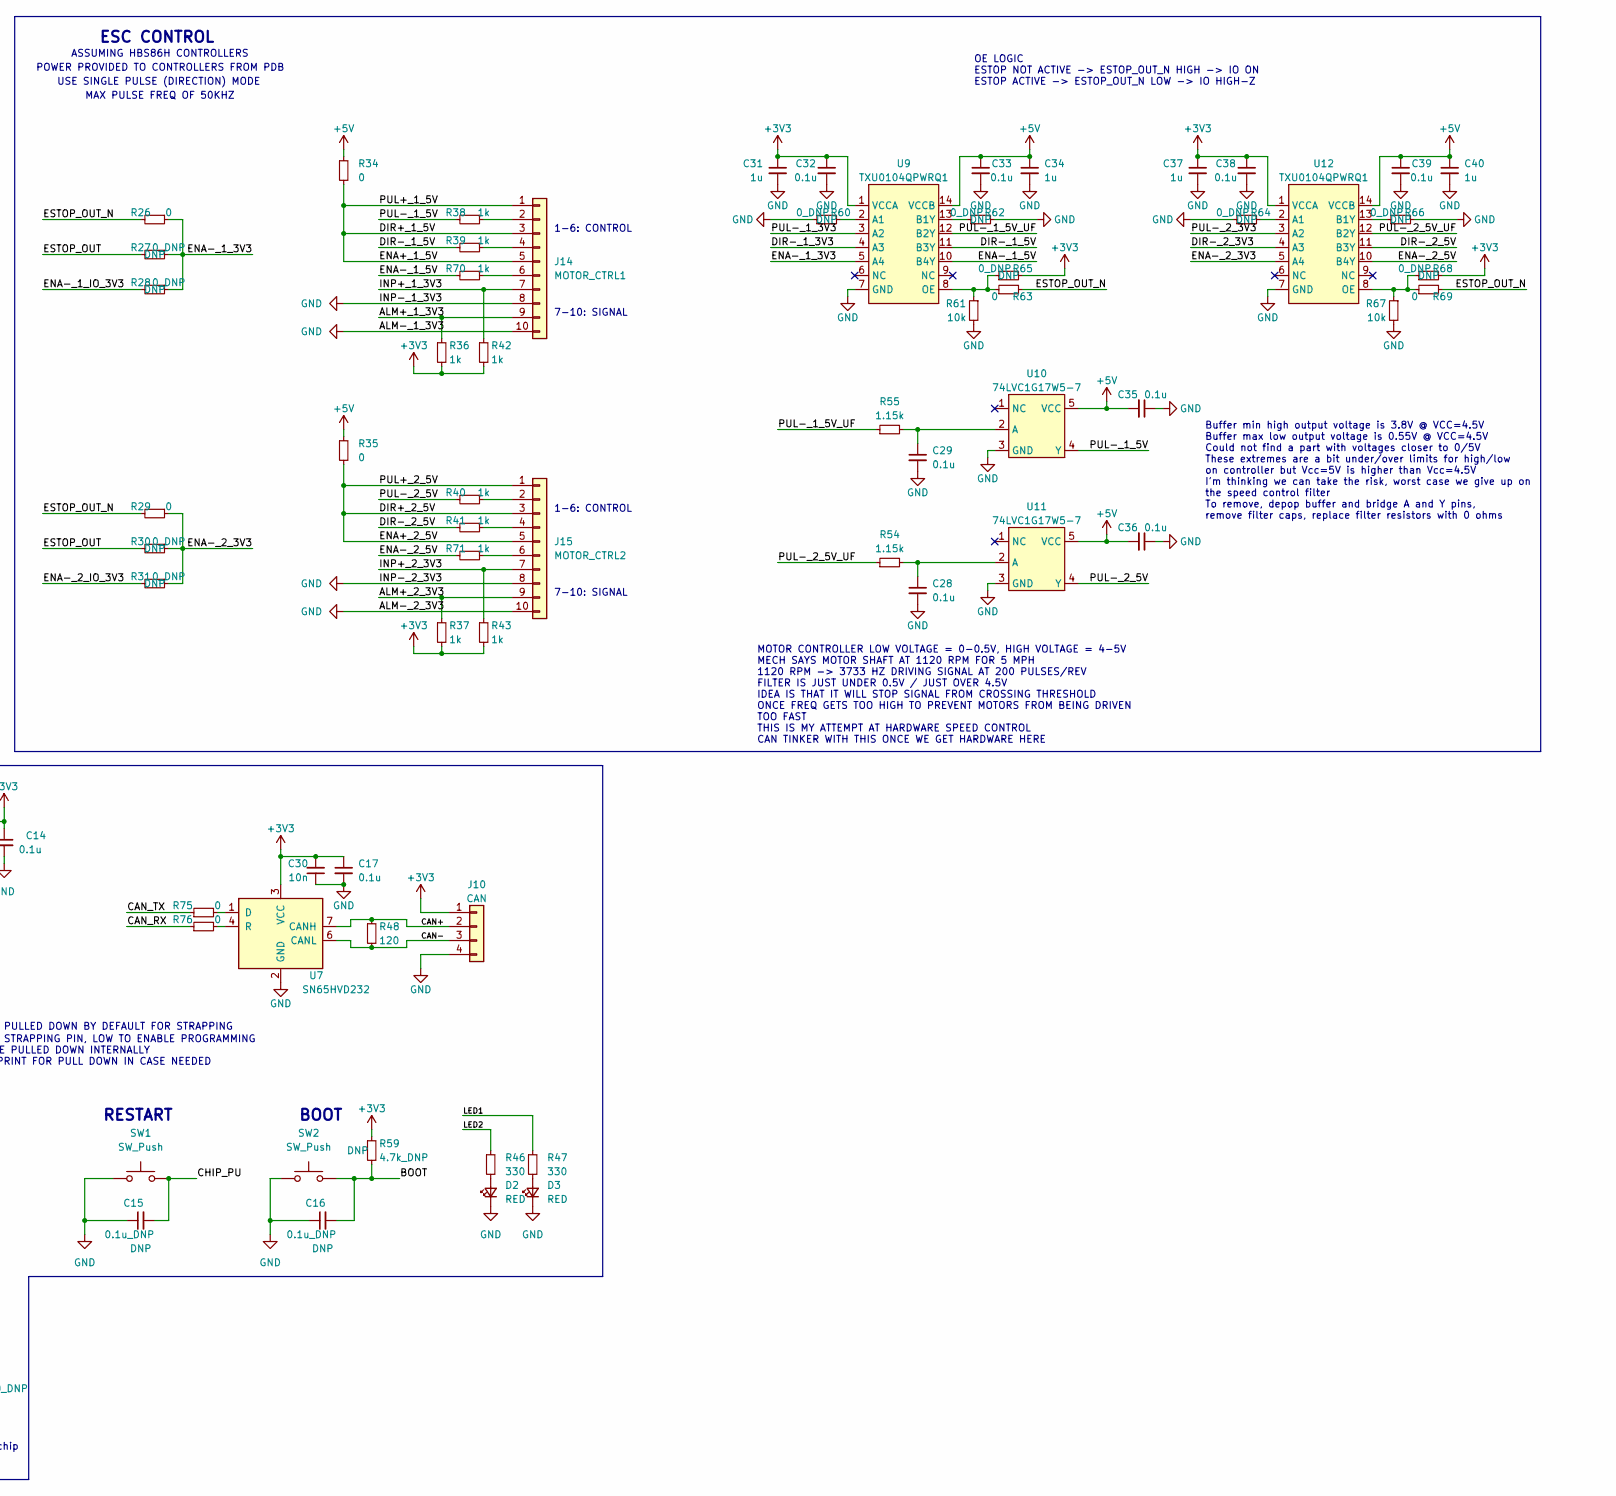
[picture p25: schematic ControlBoard.kicad_sch, part in row 1, column 2]

Parts:
C1: 1u; C_0805_2012Metric; LCSC C116352
C2, C10: 10u_DNP; C_0805_2012Metric; Voltage 5V
C3: 4.7u; C_0805_2012Metric; LCSC C87998
C4: 10u; C_0805_2012Metric; Voltage 12V; LCSC C237493
C5, C8: 10u; C_0805_2012Metric; Voltage 5V; LCSC C237493
C6: 1uF; C_0805_2012Metric; Rating 16V; Voltage 3.3V; LCSC C116352
C7, C9, C12, C19, C21: 0.1u; C_0805_2012Metric; LCSC C519981
C11, C17, C25, C32, C38: 0.1u; C_0805_2012Metric; Voltage 3.3V; LCSC C519981
C13: 22uF; C_0805_2012Metric; Rating 25V; LCSC C128856
C14: 0.1u; C_0805_2012Metric; Rating 25V; LCSC C519981
C15, C16: 0.1u_DNP; C_0805_2012Metric; Voltage 3.3V
C18: 10u; C_0805_2012Metric; Voltage 3.3V; LCSC C237493
C22, C27: 0.1u; C_0805_2012Metric; Voltage 12V; LCSC C519981
C23, C24, C28, C29, C33, C35, C36, C39: 0.1u; C_0805_2012Metric; Voltage 5V; LCSC C519981
C26: 33uF; CP_Radial_D8.0mm_P3.50mm; Digikey 1189-2152-ND
C30: 10n; C_0805_2012Metric; Voltage 3.3V; LCSC C2688117
C31, C37: 1u; C_0805_2012Metric; Voltage 3.3V; LCSC C116352
C34, C40: 1u; C_0805_2012Metric; Voltage 5V; LCSC C116352
D1, D4, D6, D7, D8, D10: SMAJ5.0CA; D_SMA; Digikey SMAJ5.0CALFCT-ND
D2, D3: RED; LED_0603_1608Metric; Digikey 160-1445-1-ND
D5, D9: SL04-E3-08_DNP; D_SMF; Digikey SL04-E3-08GICT-ND
D11: S1G; D_SMA; Digikey 1655-S1GCT-ND
H1, H2, H3, H4: M3; MountingHole_3.2mm_M3_Pad_Via
J1: Lamp 1 Out; Molex_Micro-Fit_3.0_43650-0200_1x02_P3.00mm_Horizontal; Digikey WM1860-ND
J2: ESTOP1; Molex_Micro-Fit_3.0_43650-0200_1x02_P3.00mm_Horizontal; Digikey WM1860-ND
J3: ESTOP2; JST_PH_B4B-PH-K_1x04_P2.00mm_Vertical; LCSC C566011
J4: Lamp 3 Out; Molex_Micro-Fit_3.0_43650-0200_1x02_P3.00mm_Horizontal; Digikey WM1860-ND
J5: Lamp 2 Out; Molex_Micro-Fit_3.0_43650-0200_1x02_P3.00mm_Horizontal; Digikey WM1860-ND
J6: Lamp 4 Out; Molex_Micro-Fit_3.0_43650-0200_1x02_P3.00mm_Horizontal; Digikey WM1860-ND
J7: PWR_IN; Molex_Micro-Fit_3.0_43650-0200_1x02_P3.00mm_Horizontal; Digikey WM1860-ND
J8, J11: USB_B_Micro; USB_Micro-B_Amphenol_10118194_Horizontal; Digikey 609-4618-1-ND
J9: UART BACKUP; PinHeader_1x04_P2.54mm_Vertical; Digikey 664-G800W304018EU-ND
J10: CAN; JST_PH_B4B-PH-K_1x04_P2.00mm_Vertical; LCSC C566011
J12: Conn_01x02; Molex_Micro-Fit_3.0_43650-0200_1x02_P3.00mm_Horizontal; Digikey WM1860-ND
J13: Available GPIO_DNP; PinHeader_1x05_P1.27mm_Vertical; Digikey 2057-HPH1-A-05-UA-ND
J14: MOTOR_CTRL1; Molex_Micro-Fit_3.0_43650-1000_1x10_P3.00mm_Horizontal; Digikey 23-0436501000-ND
J15: MOTOR_CTRL2; Molex_Micro-Fit_3.0_43650-1000_1x10_P3.00mm_Horizontal; Digikey 23-0436501000-ND
J16: 5V HEADER; Molex_KK-254_AE-6410-03A_1x03_P2.54mm_Vertical; Digikey WM4112-ND
Q1, Q2, Q3, Q4: DMN62D0U-13; Digikey DMN62D0U-13DICT-ND
Q5, Q6: SS8050-G; TRANS_SS8050-G; PARTREV A; Digikey 641-1790-1-ND
R1, R2, R3, R6, R7, R8, R36, R37, R38, R39, R40, R41, R42, R43, R70, R71: 1k; R_0805_2012Metric; LCSC C510097
R4: 22.1K; R_0805_2012Metric; LCSC C273840
R5: 47.5K; R_0805_2012Metric; LCSC C137519
R9, R10, R14, R15, R20, R21, R22, R23, R25, R26, R29, R34, R35, R51, R53, R63, R69, R72, R74, R75, R76: 0; R_0805_2012Metric; LCSC C237773
R11: 10k_DNP; R_0805_2012Metric
R12, R13, R18, R61, R67: 10k; R_0805_2012Metric; LCSC C110775
R16, R17, R19, R78: 0_DNP; R_0805_2012Metric
R24: 0; R_0805_2012Metric; LCSC C96345
R27, R28, R30, R31, R44, R45, R50, R60, R62, R64, R65, R66, R68, R77: 0_DNP; R_0805_2012Metric; LCSC C237773
R32, R33, R49, R52: 220; R_0805_2012Metric; LCSC C114519
R46, R47: 330; R_0805_2012Metric; LCSC C105878
R48: 120; R_0805_2012Metric; Digikey 311-120CRCT-ND
R54, R55: 1.15k; R_0805_2012Metric; LCSC C309566
R56: 2k; R_0805_2012Metric; LCSC C127985
R57, R58, R59: 4.7k_DNP; R_0805_2012Metric
SW1, SW2: SW_Push; SW_SPST_B3U-1100P-B; Digikey SW1104CT-ND
TP1, TP2, TP3, TP4, TP5, TP6: TestPoint; TestPoint_Pad_D1.0mm
U1: CP2102N-A02-GQFN28; QFN-28-1EP_5x5mm_P0.5mm_EP3.35x3.35mm; LCSC C964632
U2: Lora_Module
U3: R-78B5.0-2.0; Digikey 945-3042-ND
U4: LD1086V33-DG; TO-220-3_Vertical; Digikey 497-17820-ND
U5: ESP32-S3-WROOM-1U-N16; XCVR_ESP32-S3-WROOM-1U; PARTREV v0.6; LCSC C2980298
U6: 74LVC1G97W6-7; Digikey 74LVC1G97W6-7CT-ND
U7: SN65HVD232; SOIC-8_3.9x4.9mm_P1.27mm; LCSC C30530
U8: SN74LVC1GU04DBVR; SOT-23-5; LCSC C81934
U9, U12: TXU0104QPWRQ1; Digikey 296-TXU0104QPWRQ1CT-ND
U10, U11: 74LVC1G17W5-7; Digikey 74LVC1G17W5-7CT-ND

Connections:
+3V3: C3.1, C7.1, C11.2, C12.1, C13.1, C14.1, C17.1, C18.1, C25.1, C30.2, C31.1, C32.1, C37.1, C38.1, J9.1, J10.1, R8.1, R18.2, R23.2, R24.2, R36.2, R37.2, R42.2, R43.2, R44.1, R45.1, R51.1, R59.1, R65.2, R68.2, R77.1, TP3.1, U1.6 (VDD), U1.7 (VREGIN), U4.2 (OUT), U6.5 (VCC), U7.3 (VCC), U8.5 (VCC), U9.1 (VCCA), U12.1 (VCCA)
+5V: C5.1, C8.2, C23.2, C24.2, C33.1, C34.1, C35.2, C36.2, C39.1, C40.1, D11.1 (K), J16.2, R20.1, R21.1, R34.1, R35.1, R50.1, TP2.1, U3.3 (VOUT), U4.3 (IN), U9.14 (VCCB), U10.5 (VCC), U11.5 (VCC), U12.14 (VCCB)
+12V: C4.2, C22.2, C26.1, C27.1, J1.1, J4.1, J5.1, J6.1, J7.2, TP1.1, U3.1 (VIN)
/3V3_LORA_A: C19.2, R77.2, U2.20 (3V3)
/3V3_LORA_B: C21.2, R45.2, U2.21 (3V3)
/5V_LORA: C9.2, R20.2, U2.2 (5V)
/ALM+_1_3V3: J14.9, R36.1, U5.7 (IO7)
/ALM+_2_3V3: J15.9, R37.1, U5.30 (IO37)
/BOOT: C16.2, R15.2, R59.2, SW2.2, U5.27 (IO0)
/CAN+: J10.2, R48.1, U7.7 (CANH)
/CAN-: J10.3, R48.2, U7.6 (CANL)
/CAN_RX: R76.1, U5.24 (IO47)
/CAN_TX: R75.1, U5.25 (IO48)
/CHIP_PU: C6.1, C15.2, R14.2, R18.1, SW1.2, U5.3 (EN)
/DIR+_1_5V: J14.1, J14.3, J14.5, R34.2
/DIR+_2_5V: J15.1, J15.3, J15.5, R35.2
/DIR-_1_3V3: U5.10 (IO17), U9.4 (A3)
/DIR-_1_5V: R39.2, U9.11 (B3Y)
/DIR-_2_3V3: U5.33 (IO40), U12.4 (A3)
/DIR-_2_5V: R41.2, U12.11 (B3Y)
/DTR: Q6.2, R12.1, U1.28 (~DTR)
/ENA-_1_3V3: R26.1, R27.1, R28.1, U9.5 (A4)
/ENA-_1_5V: R70.2, U9.10 (B4Y)
/ENA-_1_IO_3V3: R28.2, U5.9 (IO16)
/ENA-_2_3V3: R29.1, R30.1, R31.1, U12.5 (A4)
/ENA-_2_5V: R71.2, U12.10 (B4Y)
/ENA-_2_IO_3V3: R31.2, U5.32 (IO39)
/ESTOP_M: J2.2, R3.1, R25.1, TP5.1
/ESTOP_OUT: J12.1, R27.2, R30.2, TP4.1, U5.17 (IO9), U6.4 (Y), U8.2
/ESTOP_OUT_N: R26.2, R29.2, R63.2, R69.2, U8.4
/ESTOP_W: J3.2, R22.2, R53.1, R56.1, TP6.1
/GPIO11: J13.1, U5.19 (IO11)
/GPIO12: J13.2, U5.20 (IO12)
/GPIO13: J13.3, U5.21 (IO13)
/GPIO14: J13.4, U5.22 (IO14)
/GPIO21: J13.5, U5.23 (IO21)
/INP+_1_3V3: J14.7, R42.1, U5.8 (IO15)
/INP+_2_3V3: J15.7, R43.1, U5.31 (IO38)
/LAMP1_ON: R1.1, R32.2, U5.4 (IO4)
/LAMP2_ON: R6.1, R49.2, U5.5 (IO5)
/LAMP3_ON: R2.1, R33.2, U5.38 (IO2)
/LAMP4_ON: R7.1, R52.2, U5.39 (IO1)
/LED1: R47.1, U5.18 (IO10)
/LED2: R46.1, U5.28 (IO35)
/PUL-_1_3V3: U5.11 (IO18), U9.3 (A2)
/PUL-_1_5V: R38.2, U10.4 (Y)
/PUL-_1_5V_UF: R55.1, U9.12 (B2Y)
/PUL-_2_3V3: U5.34 (IO41), U12.3 (A2)
/PUL-_2_5V: R40.2, U11.4 (Y)
/PUL-_2_5V_UF: R54.1, U12.12 (B2Y)
/RTS: Q5.2, R13.1, U1.24 (~RTS)
/U0RXD: J9.3, R9.1, U5.36 (RXD0)
/U0TXD: J9.2, R10.1, U5.37 (TXD0)
/USB_D+: D8.1 (A1), J11.3 (D+), U5.14 (IO20)
/USB_D-: D10.1 (A1), J11.2 (D-), U5.13 (IO19)
/USB_DN: D6.1 (A1), J8.2 (D-), U1.5 (D-)
/USB_DP: D4.1 (A1), J8.3 (D+), U1.4 (D+)
/VBUS: D1.1 (A1), D5.2 (A), J8.1 (VBUS), R4.1
/VBUSB: D7.1 (A1), D9.2 (A), J11.1 (VBUS)
/nESTOP_W: J3.3
GND: C1.2, C2.1, C3.2, C4.1, C5.2, C6.2, C7.2, C8.1, C9.1, C10.1, C11.1, C12.2, C13.2, C14.2, C15.1, C16.1, C17.2, C18.2, C19.1, C21.1, C22.1, C23.1, C24.1, C25.2, C26.2, C27.2, C28.2, C29.2, C30.1, C31.2, C32.2, C33.2, C34.2, C35.1, C36.1, C37.2, C38.2, C39.2, C40.2, D1.2 (A2), D2.1 (K), D3.1 (K), D4.2 (A2), D6.2 (A2), D7.2 (A2), D8.2 (A2), D10.2 (A2), D11.2 (A), J3.1, J7.1, J8.5 (GND), J8.6 (Shield), J9.4, J10.4, J11.5 (GND), J11.6 (Shield), J12.2, J14.8, J14.10, J15.8, J15.10, J16.3, Q1.2 (S), Q2.2 (S), Q3.2 (S), Q4.2 (S), R1.2, R2.2, R3.2, R5.2, R6.2, R7.2, R11.2, R16.2, R17.2, R19.2, R56.2, R57.1, R58.1, R60.1, R61.2, R62.2, R64.1, R66.2, R67.2, R72.1, R74.2, R78.2, SW1.1, SW2.1, U1.3 (GND), U1.29 (GND), U3.2 (GND), U4.1 (ADJ/GND), U5.1 (GND), U5.40 (GND), U5.41_1 (GND), U5.41_2 (GND), U5.41_3 (GND), U5.41_4 (GND), U5.41_5 (GND), U5.41_6 (GND), U5.41_7 (GND), U5.41_8 (GND), U5.41_9 (GND), U6.2 (GND), U7.2 (GND), U8.3 (GND), U9.7 (GND), U10.3 (GND), U11.3 (GND), U12.7 (GND)
unnamed: C1.1, R4.2, R5.1, U1.8 (VBUS)
unnamed: C2.2, D5.1 (K)
unnamed: C10.2, D9.1 (K)
unnamed: C28.1, R54.2, U11.2 (A)
unnamed: C29.1, R55.2, U10.2 (A)
unnamed: D2.2 (A), R46.2
unnamed: D3.2 (A), R47.2
unnamed: H1.1, R78.1
unnamed: H2.1, R16.1
unnamed: H3.1, R17.1
unnamed: H4.1, R19.1
unnamed: J1.2, Q1.3 (D)
unnamed: J2.1, R50.2, R51.2
unnamed: J3.4, R21.2, R44.2
unnamed: J4.2, Q2.3 (D)
unnamed: J5.2, Q3.3 (D)
unnamed: J6.2, Q4.3 (D)
unnamed: J14.2, R38.1
unnamed: J14.4, R39.1
unnamed: J14.6, R70.1
unnamed: J15.2, R40.1
unnamed: J15.4, R41.1
unnamed: J15.6, R71.1
unnamed: Q1.1 (G), R32.1
unnamed: Q2.1 (G), R33.1
unnamed: Q3.1 (G), R49.1
unnamed: Q4.1 (G), R52.1
unnamed: Q5.1, R12.2
unnamed: Q5.3, R14.1
unnamed: Q6.1, R13.2
unnamed: Q6.3, R15.1
unnamed: R8.2, U1.9 (~RST)
unnamed: R9.2, U1.26 (TXD)
unnamed: R10.2, U1.25 (RXD)
unnamed: R11.1, U1.11 (~SUSPEND)
unnamed: R22.1, U6.1 (IN1)
unnamed: R23.1, U6.3 (IN0)
unnamed: R24.1, U5.2 (3V3)
unnamed: R25.2, U6.6 (IN2)
unnamed: R53.2, U2.34 (GPIO12)
unnamed: R57.2, U5.26 (IO45)
unnamed: R58.2, U5.16 (IO46)
unnamed: R60.2, U9.2 (A1)
unnamed: R61.1, R63.1, R65.1, U9.8 (OE)
unnamed: R62.1, U9.13 (B1Y)
unnamed: R64.2, U12.2 (A1)
unnamed: R66.1, U12.13 (B1Y)
unnamed: R67.1, R68.1, R69.1, U12.8 (OE)
unnamed: R72.2, U2.1 (GND)
unnamed: R74.1, U2.19 (GND)
unnamed: R75.2, U7.1 (D)
unnamed: R76.2, U7.4 (R)

Notes on the sheet:
2 INPUT OR GATE
These IO are next to eachother on the chip
Not sure if this IO is 3.3V or 5V I think U6 can take up to 5V input regardless of VCC but add divider option just in case 2k should pull net down If needed replace 0 ohm with 1k
FET PN: DMN62D0U-13
Have seen conflicting pinouts for this online Current pinout matches Amazon picture of what we ordered 0 ohms in case pinout is wrong
POWER
ASSUMING HBS86H CONTROLLERS
MCU STUFF
SAFETY LIGHTS
Buffer min high output voltage is 3.8V @ VCC=4.5V Buffer max low output voltage is 0.55V @ VCC=4.5V Could not find a part with voltages closer to 0/5V These extremes are a bit under/over limits for high/low on controller but Vcc=5V is higher than Vcc=4.5V I'm thinking we can take the risk, worst ca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
1-6: CONTROL
POWER PROVIDED TO CONTROLLERS FROM PDB
ESC CONTROL
GPIO3 FLOATING STRAP
MOTOR CONTROLLER LOW VOLTAGE = 0-0.5V, HIGH VOLTAGE = 4-5V MECH SAYS MOTOR SHAFT AT 1120 RPM FOR 5 MPH 1120 RPM -> 3733 HZ DRIVING SIGNAL AT 200 PULSES/REV FILTER IS JUST UNDER 0.5V / JUST OVER 4.5V IDEA IS THAT IT WILL STOP SIGNAL FROM CROSSING THRESHOLD ONCE FREQ GETS TOO HIGH TO PREVENT MOTORS F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
REVIEW V0.04
USB to UART
From PDB
7-10: SIGNAL
Leave J3 in case on-board module fails
USE SINGLE PULSE (DIRECTION) MODE
GPIO46 IS STRAPPING PIN, LOW TO ENABLE PROGRAMMING SHOULD BE PULLED DOWN INTERNALLY ADD FOOTPRINT FOR PULL DOWN IN CASE NEEDED
DO NOT GET CHIP WITH OSPI SRAM
RESTART
ESTOP
BOOT
Lamps are 12V 60mA, FETs dissipate 9mW
GPIO45 IS PULLED DOWN BY DEFAULT FOR STRAPPING
MAX PULSE FREQ OF 50KHZ
OE LOGIC ESTOP NOT ACTIVE -> ESTOP_OUT_N HIGH -> IO ON ESTOP ACTIVE -> ESTOP_OUT_N LOW -> IO HIGH-Z

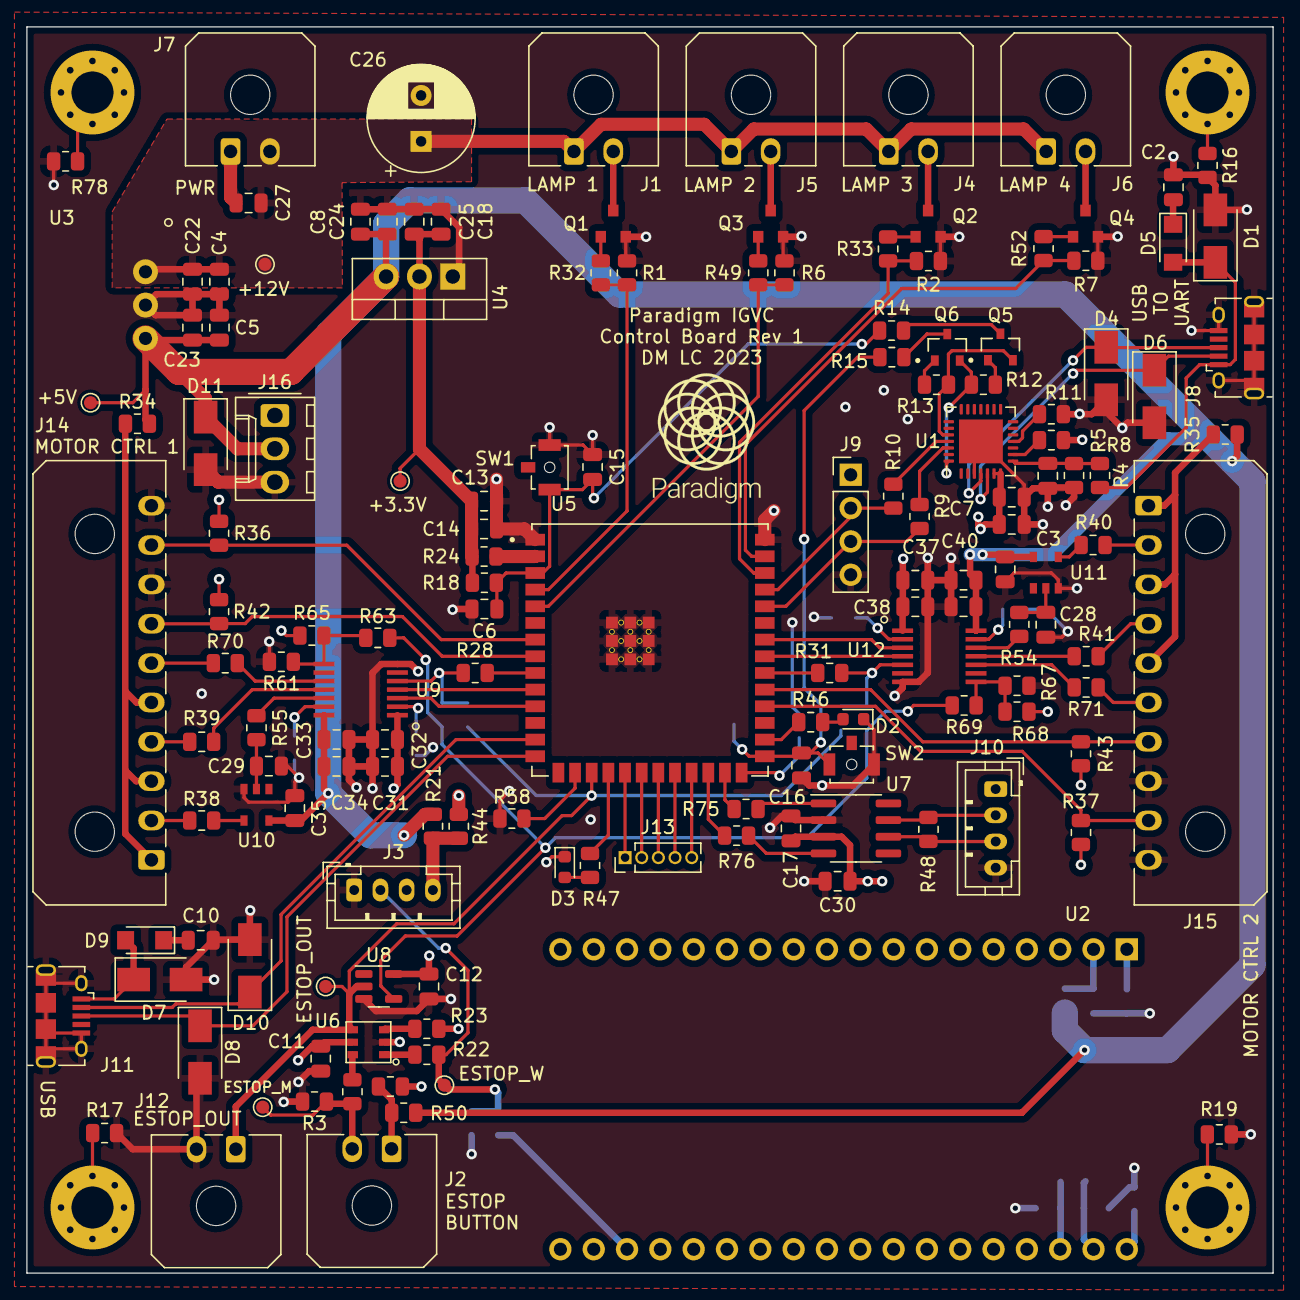
[picture p26: board ControlBoard.kicad_pcb from above]

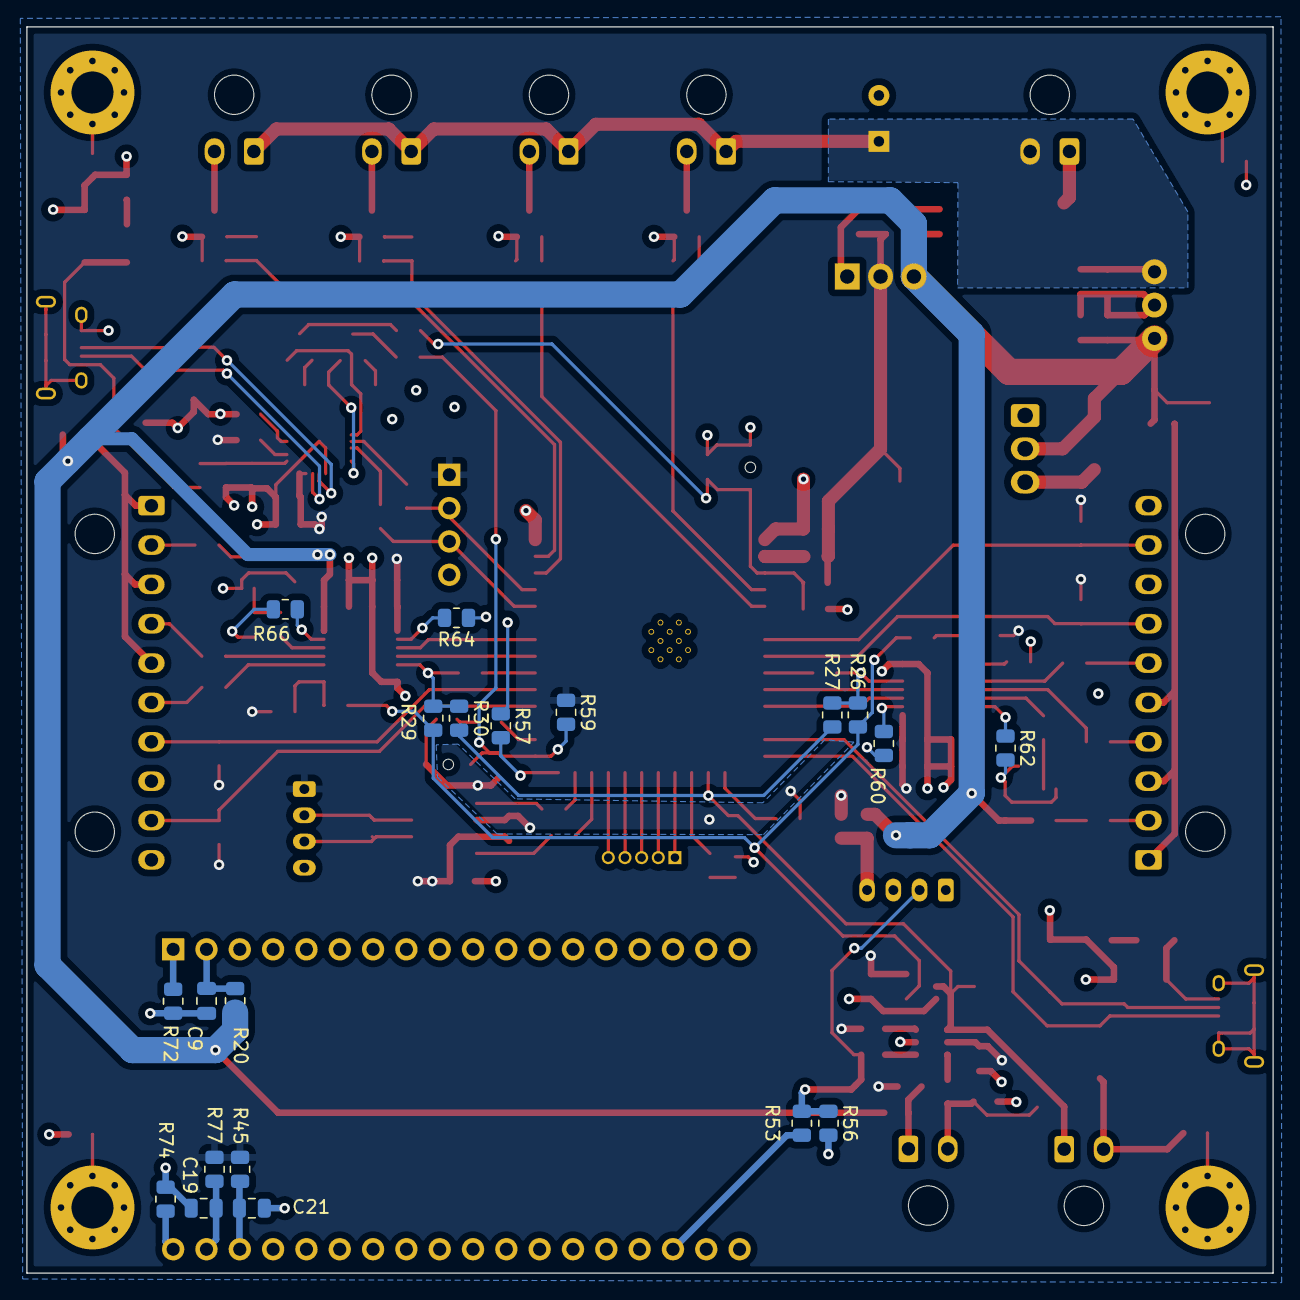
[picture p27: board ControlBoard.kicad_pcb from below]

Board: 4 copper layers, 95.0 x 95.0 mm, 173 parts (20 on the bottom side), 112 nets.
