ParadigmEngineering/igvc-2023-hardware/hardware/PowerDistributionBoard/PowerDistributionBoard/PowerDistributionBoard.kicad_pcb

## KiCad design hardware/PowerDistributionBoard/PowerDistributionBoard/PowerDistributionBoard.kicad_pcb (2023-04-24)

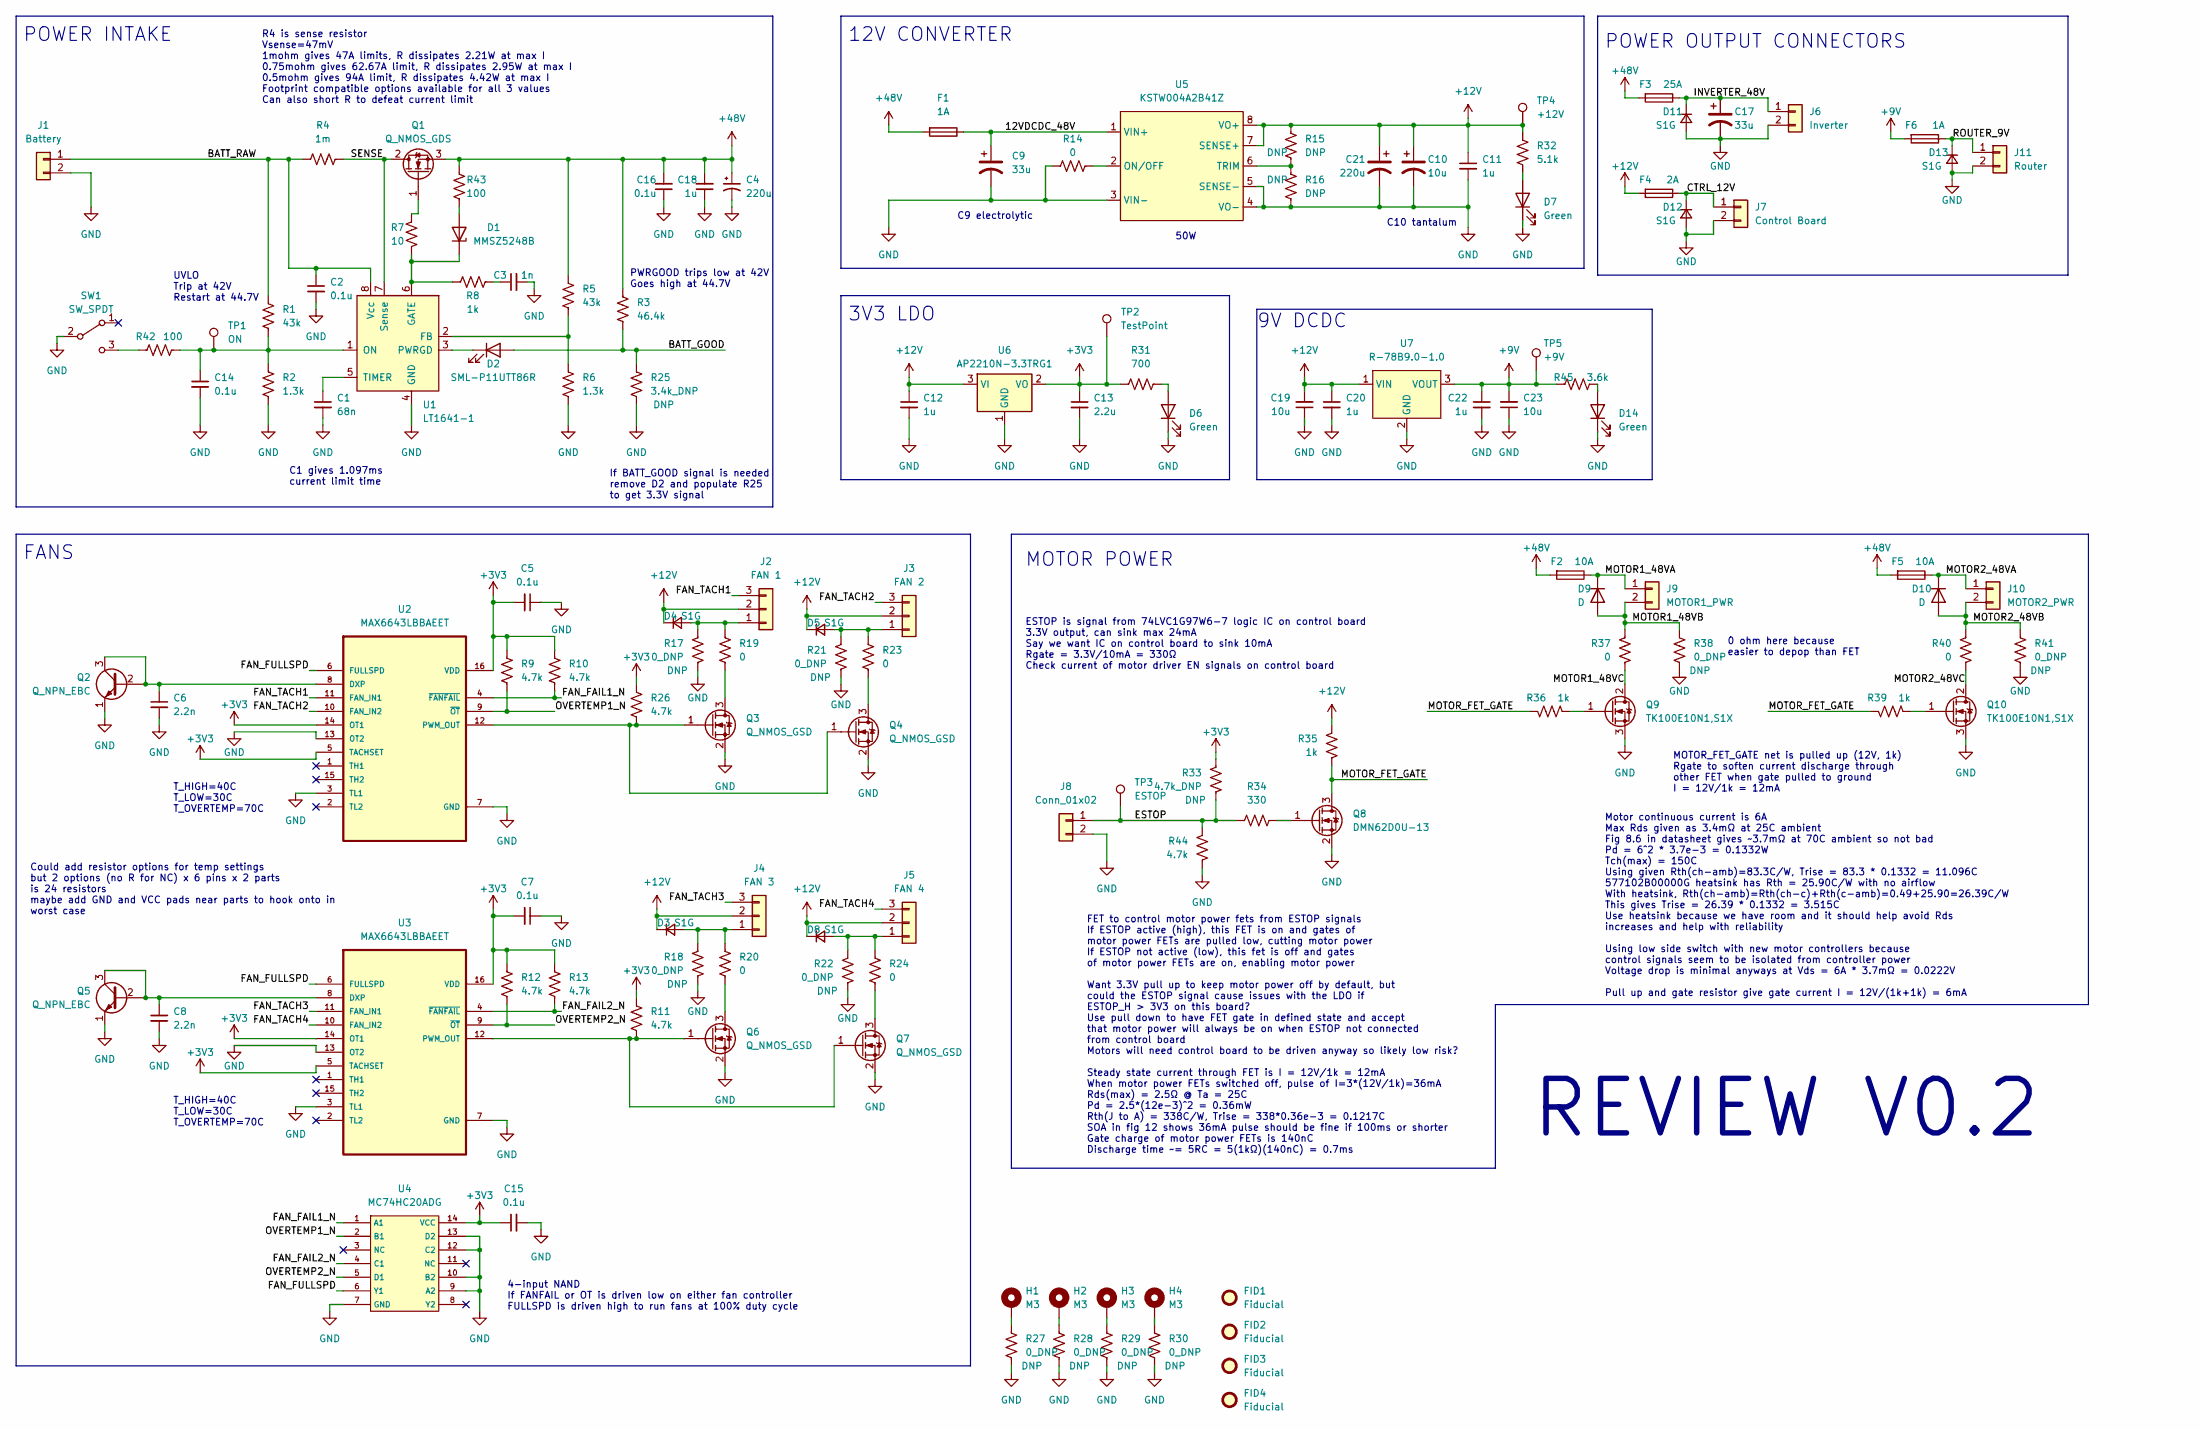
[picture p28: schematic PowerDistributionBoard.kicad_sch]

Parts:
C1: 68n; C_0805_2012Metric; Voltage 44V; LCSC C113842
C2, C14, C16: 0.1u; C_0805_2012Metric; Voltage 48V; LCSC C28233
C3: 1n; C_0805_2012Metric; Voltage 68V; LCSC C16005
C4: 220u; CP_Radial_D16.0mm_P7.50mm; Voltage 48V; Digikey 493-5867-ND
C5, C7, C15: 0.1u; C_0805_2012Metric; Voltage 3.3V; LCSC C597440
C6, C8: 2.2n; C_0805_2012Metric; Voltage 0.8V; LCSC C1728
C9, C17: 33u; CP_Radial_D10.0mm_P5.00mm; Digikey 1189-2207-ND
C10: 10u; C_1206_3216Metric; Digikey 478-10001-1-ND
C11, C12, C20: 1u; C_0805_2012Metric; Voltage 12V; LCSC C116352
C13: 2.2u; C_0805_2012Metric; Voltage 3.3V; LCSC C107366
C18: 1u; C_0805_2012Metric; Voltage 48V; LCSC C28233
C19: 10u; C_0805_2012Metric; Voltage 12V; LCSC C237493
C21: 220u; CP_Radial_D6.3mm_P2.50mm; Voltage 12V; Digikey 1189-2913-ND
C22: 1u; C_0805_2012Metric; Voltage 9V; LCSC C116352
C23: 10u; C_0805_2012Metric; Voltage 9V; LCSC C237493
D1: MMSZ5248B; D_SOD-123; Digikey MMSZ5248B-HE3-08GICT-ND
D2: SML-P11UTT86R; LED_0402_1005Metric; Digikey SML-P11UTT86RCT-ND
D3, D4, D5, D8, D11, D12, D13: S1G; D_SMA; Digikey 1655-S1GCT-ND
D6, D7, D14: Green; LED_0805_2012Metric_Pad1.15x1.40mm_HandSolder; Digikey 492-2525-1-ND
D9, D10: D; VS-15AWL06FNTR-M3; Digikey VS-15AWL06FNTR-M3GICT-ND
F1, F6: 1A; 3557-2; Digikey 36-3557-2-ND
F2, F5: 10A; 3557-2; Digikey 36-3557-2-ND
F3: 25A; 3557-2; Digikey 36-3557-2-ND
F4: 2A; 3557-2; Digikey 36-3557-2-ND
FID1, FID2, FID3, FID4: Fiducial; Fiducial_1mm_Mask2mm
H1, H2, H3, H4: M3; MountingHole_3.2mm_M3_Pad_Via
J1: Battery; Molex_Mini-Fit_Sr_42820-22XX_1x02_P10.00mm_Horizontal; Digikey WM11250-ND
J2: FAN 1; Molex_KK-254_AE-6410-03A_1x03_P2.54mm_Vertical; Digikey WM4112-ND
J3: FAN 2; Molex_KK-254_AE-6410-03A_1x03_P2.54mm_Vertical; Digikey WM4112-ND
J4: FAN 3; Molex_KK-254_AE-6410-03A_1x03_P2.54mm_Vertical; Digikey WM4112-ND
J5: FAN 4; Molex_KK-254_AE-6410-03A_1x03_P2.54mm_Vertical; Digikey WM4112-ND
J6: Inverter; Molex_Mini-Fit_Sr_42820-22XX_1x02_P10.00mm_Horizontal; Digikey WM11250-ND
J7: Control Board; Molex_Micro-Fit_3.0_43650-0215_1x02_P3.00mm_Vertical; Digikey WM1917-ND
J8: Conn_01x02; Molex_Micro-Fit_3.0_43650-0215_1x02_P3.00mm_Vertical; Digikey WM1917-ND
J9: MOTOR1_PWR; Molex_Mini-Fit_Sr_42820-22XX_1x02_P10.00mm_Horizontal; Digikey WM11250-ND
J10: MOTOR2_PWR; Molex_Mini-Fit_Sr_42820-22XX_1x02_P10.00mm_Horizontal; Digikey WM11250-ND
J11: Router; Molex_Micro-Fit_3.0_43650-0215_1x02_P3.00mm_Vertical; Digikey WM1917-ND
Q1: Q_NMOS_GDS; TO-263-2; Digikey 296-49604-1-ND
Q2, Q5: Q_NPN_EBC; SST3904T116CT-ND; Digikey SST3904T116CT-ND
Q3, Q4, Q6, Q7: Q_NMOS_GSD; SC-59; Digikey BSR802NL6327HTSA1CT-ND
Q8: DMN62D0U-13; Digikey DMN62D0U-13DICT-ND
Q9, Q10: TK100E10N1,S1X; TO-220-3_Vertical; Digikey TK100E10N1S1X-ND
R1, R5: 43k; R_0805_2012Metric; LCSC C137524
R2, R6: 1.3k; R_0805_2012Metric; LCSC C137582
R3: 46.4k; R_0805_2012Metric; LCSC C317450
R4: 1m; Y14860R00075F9R; Digikey_0.75m 804-Y14860R00075F9RCT-ND
R7: 10; R_0805_2012Metric; LCSC C2074472
R8, R35, R36, R39: 1k; R_0805_2012Metric; LCSC C510097
R9, R10, R11, R12, R13, R26, R44: 4.7k; R_0805_2012Metric; LCSC C140869
R14, R19, R20, R23, R24: 0; R_0805_2012Metric; LCSC C237773
R15, R16: DNP; R_0805_2012Metric
R17, R18, R21, R22, R27, R28, R29, R30: 0_DNP; R_0805_2012Metric
R25: 3.4k_DNP; R_0805_2012Metric
R31: 700; R_0805_2012Metric; LCSC C483228
R32: 5.1k; R_0805_2012Metric; LCSC C84375
R33: 4.7k_DNP; R_0805_2012Metric
R34: 330; R_0805_2012Metric; LCSC C105878
R37, R40: 0; R_2512_6332Metric; Digikey HCJ2512ZT0R00CT-ND
R38, R41: 0_DNP; R_2512_6332Metric; Digikey HCJ2512ZT0R00CT-ND
R42, R43: 100; R_0805_2012Metric; LCSC C105577
R45: 3.6k; R_0805_2012Metric; LCSC C137533
SW1: SW_SPDT; EG1218; Digikey EG1903-ND
TP1: ON; TestPoint_Pad_D1.0mm
TP2: TestPoint; TestPoint_Pad_D1.0mm
TP3: ESTOP; TestPoint_Pad_D1.0mm
TP4: +12V; TestPoint_Pad_D1.0mm
TP5: +9V; TestPoint_Pad_D1.0mm
U1: LT1641-1; LT1641-1CS8#TRPBF; Digikey LT1641-1CS8#TRPBFCT-ND
U2, U3: MAX6643LBBAEET; QSOP-16_3.9x4.9mm_P0.635mm; Digikey MAX6643LBBAEE+TCT-ND
U4: MC74HC20ADG; SOIC-14_3.9x8.7mm_P1.27mm; Digikey MC74HC20ADGOS-ND
U5: KSTW004A2B41Z; CONV_KSTW004A2B41Z; Digikey 555-1330-ND
U6: AP2210N-3.3TRG1; Digikey AP2210N-3.3TRG1DICT-ND
U7: R-78B9.0-1.0; Digikey 945-1056-ND

Connections:
+3V3: C5.2, C7.2, C13.1, C15.1, R9.1, R10.1, R11.1, R12.1, R13.1, R26.1, R31.2, R33.2, TP2.1, U2.5 (TACHSET), U2.14 (OT1), U2.16 (VDD), U3.5 (TACHSET), U3.14 (OT1), U3.16 (VDD), U4.14 (VCC), U6.2 (VO)
+9V: C22.1, C23.2, F6.2, R45.2, TP5.1, U7.3 (VOUT)
+12V: C10.1, C11.1, C12.1, C19.2, C20.1, C21.1, D3.1 (K), D4.1 (K), D5.1 (K), D8.1 (K), F4.2, J2.2, J3.2, J4.2, J5.2, R15.1, R32.1, R35.2, TP4.1, U5.7 (SENSE+), U5.8 (VO+), U6.3 (VI), U7.1 (VIN)
+48V: C4.1, C16.2, C18.2, F1.2, F2.2, F3.2, F5.2, Q1.3 (S), R3.1, R5.1, R43.2
/12VDCDC_48V: C9.1, F1.1, U5.1 (VIN+)
/BATT_GOOD: D2.2 (A), R3.2, R25.1
/BATT_RAW: C2.1, J1.1, R1.1, R4.2, U1.8 (Vcc)
/CTRL_12V: D12.1 (K), F4.1, J7.1
/ESTOP: J8.1, R33.1, R34.2, R44.2, TP3.1
/FAN_FAIL1_N: R10.2, U2.4 (~FANFAIL), U4.1 (A1)
/FAN_FAIL2_N: R13.2, U3.4 (~FANFAIL), U4.4 (C1)
/FAN_FULLSPD: U2.6 (FULLSPD), U3.6 (FULLSPD), U4.6 (Y1)
/FAN_TACH1: J2.3, U2.11 (FAN_IN1)
/FAN_TACH2: J3.3, U2.10 (FAN_IN2)
/FAN_TACH3: J4.3, U3.11 (FAN_IN1)
/FAN_TACH4: J5.3, U3.10 (FAN_IN2)
/INVERTER_48V: C17.1, D11.1 (K), F3.1, J6.1
/MOTOR1_48VA: D9.1 (K), F2.1, J9.1
/MOTOR1_48VB: D9.2 (A), J9.2, R37.2, R38.1
/MOTOR1_48VC: Q9.2 (D), R37.1
/MOTOR2_48VA: D10.1 (K), F5.1, J10.1
/MOTOR2_48VB: D10.2 (A), J10.2, R40.2, R41.1
/MOTOR2_48VC: Q10.2 (D), R40.1
/MOTOR_FET_GATE: Q8.3 (D), R35.1, R36.1, R39.1
/OVERTEMP1_N: R9.2, U2.9 (~OT), U4.2 (B1)
/OVERTEMP2_N: R12.2, U3.9 (~OT), U4.5 (D1)
/ROUTER_9V: D13.1 (K), F6.1, J11.1
/SENSE: Q1.2 (D), R4.1, U1.7 (Sense)
GND: C1.2, C2.2, C3.2, C4.2, C5.1, C6.2, C7.1, C8.2, C9.2, C10.2, C11.2, C12.2, C13.2, C14.2, C15.2, C16.1, C17.2, C18.1, C19.1, C20.2, C21.2, C22.2, C23.1, D6.1 (K), D7.1 (K), D11.2 (A), D12.2 (A), D13.2 (A), D14.1 (K), J1.2, J6.2, J7.2, J8.2, J11.2, Q2.1 (E), Q3.2 (S), Q4.2 (S), Q5.1 (E), Q6.2 (S), Q7.2 (S), Q8.2 (S), Q9.3 (S), Q10.3 (S), R2.2, R6.2, R14.2, R16.2, R17.1, R18.1, R21.1, R22.1, R25.2, R27.2, R28.2, R29.2, R30.2, R38.2, R41.2, R44.1, SW1.2 (B), U1.4 (GND), U2.3 (TL1), U2.7 (GND), U2.13 (OT2), U3.3 (TL1), U3.7 (GND), U3.13 (OT2), U4.7 (GND), U4.9 (A2), U4.10 (B2), U4.12 (C2), U4.13 (D2), U5.3 (VIN-), U5.4 (VO-), U5.5 (SENSE-), U6.1 (GND), U7.2 (GND)
unnamed: C1.1, U1.5 (TIMER)
unnamed: C3.1, R8.1
unnamed: C6.1, Q2.2 (B), Q2.3 (C), U2.8 (DXP)
unnamed: C8.1, Q5.2 (B), Q5.3 (C), U3.8 (DXP)
unnamed: C14.1, R1.2, R2.1, R42.1, TP1.1, U1.1 (ON)
unnamed: D1.1 (K), R7.1, R8.2, U1.6 (GATE)
unnamed: D1.2 (A), R43.1
unnamed: D2.1 (K), U1.3 (PWRGD)
unnamed: D3.2 (A), J4.1, R18.2, R20.1
unnamed: D4.2 (A), J2.1, R17.2, R19.1
unnamed: D5.2 (A), J3.1, R21.2, R23.1
unnamed: D6.2 (A), R31.1
unnamed: D7.2 (A), R32.2
unnamed: D8.2 (A), J5.1, R22.2, R24.1
unnamed: D14.2 (A), R45.1
unnamed: H1.1, R27.1
unnamed: H2.1, R28.1
unnamed: H3.1, R29.1
unnamed: H4.1, R30.1
unnamed: Q1.1 (G), R7.2
unnamed: Q3.1 (G), Q4.1 (G), R26.2, U2.12 (PWM_OUT)
unnamed: Q3.3 (D), R19.2
unnamed: Q4.3 (D), R23.2
unnamed: Q6.1 (G), Q7.1 (G), R11.2, U3.12 (PWM_OUT)
unnamed: Q6.3 (D), R20.2
unnamed: Q7.3 (D), R24.2
unnamed: Q8.1 (G), R34.1
unnamed: Q9.1 (G), R36.2
unnamed: Q10.1 (G), R39.2
unnamed: R5.2, R6.1, U1.2 (FB)
unnamed: R14.1, U5.2 (ON/OFF)
unnamed: R15.2, R16.1, U5.6 (TRIM)
unnamed: R42.2, SW1.3 (C)

Notes on the sheet:
C9 electrolytic
POWER INTAKE
C1 gives 1.097ms current limit time
POWER OUTPUT CONNECTORS
Motor continuous current is 6A Max Rds given as 3.4mΩ at 25C ambient Fig 8.6 in datasheet gives ~3.7mΩ at 70C ambient so not bad Pd = 6^2 * 3.7e-3 = 0.1332W Tch(max) = 150C Using given Rth(ch-amb)=83.3C/W, Trise = 83.3 * 0.1332 = 11.096C 577102B00000G heatsink has Rth = 25.90C/W with no airflow Wit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
T_HIGH=40C T_LOW=30C T_OVERTEMP=70C
UVLO Trip at 42V Restart at 44.7V
PWRGOOD trips low at 42V Goes high at 44.7V
4-input NAND If FANFAIL or OT is driven low on either fan controller FULLSPD is driven high to run fans at 100% duty cycle
0 ohm here because easier to depop than FET
R4 is sense resistor Vsense=47mV 1mohm gives 47A limits, R dissipates 2.21W at max I 0.75mohm gives 62.67A limit, R dissipates 2.95W at max I 0.5mohm gives 94A limit, R dissipates 4.42W at max I Footprint compatible options available for all 3 values Can also short R to defeat current limit
50W
Could add resistor options for temp settings but 2 options (no R for NC) x 6 pins x 2 parts is 24 resistors maybe add GND and VCC pads near parts to hook onto in worst case
MOTOR_FET_GATE net is pulled up (12V, 1k) Rgate to soften current discharge through other FET when gate pulled to ground I = 12V/1k = 12mA
C10 tantalum
3V3 LDO
If BATT_GOOD signal is needed remove D2 and populate R25 to get 3.3V signal
12V CONVERTER
REVIEW V0.2
FANS
ESTOP is signal from 74LVC1G97W6-7 logic IC on control board 3.3V output, can sink max 24mA Say we want IC on control board to sink 10mA Rgate = 3.3V/10mA = 330Ω Check current of motor driver EN signals on control board
MOTOR POWER
FET to control motor power fets from ESTOP signals If ESTOP active (high), this FET is on and gates of motor power FETs are pulled low, cutting motor power If ESTOP not active (low), this fet is off and gates of motor power FETs are on, enabling motor power Want 3.3V pull up to keep motor power off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
9V DCDC
