ParadigmEngineering/igvc-2023-hardware/hardware/PowerDistributionBoard/PowerDistributionBoard/PowerDistributionBoard.kicad_pcb

## KiCad design hardware/PowerDistributionBoard/PowerDistributionBoard/PowerDistributionBoard.kicad_pcb (continued)

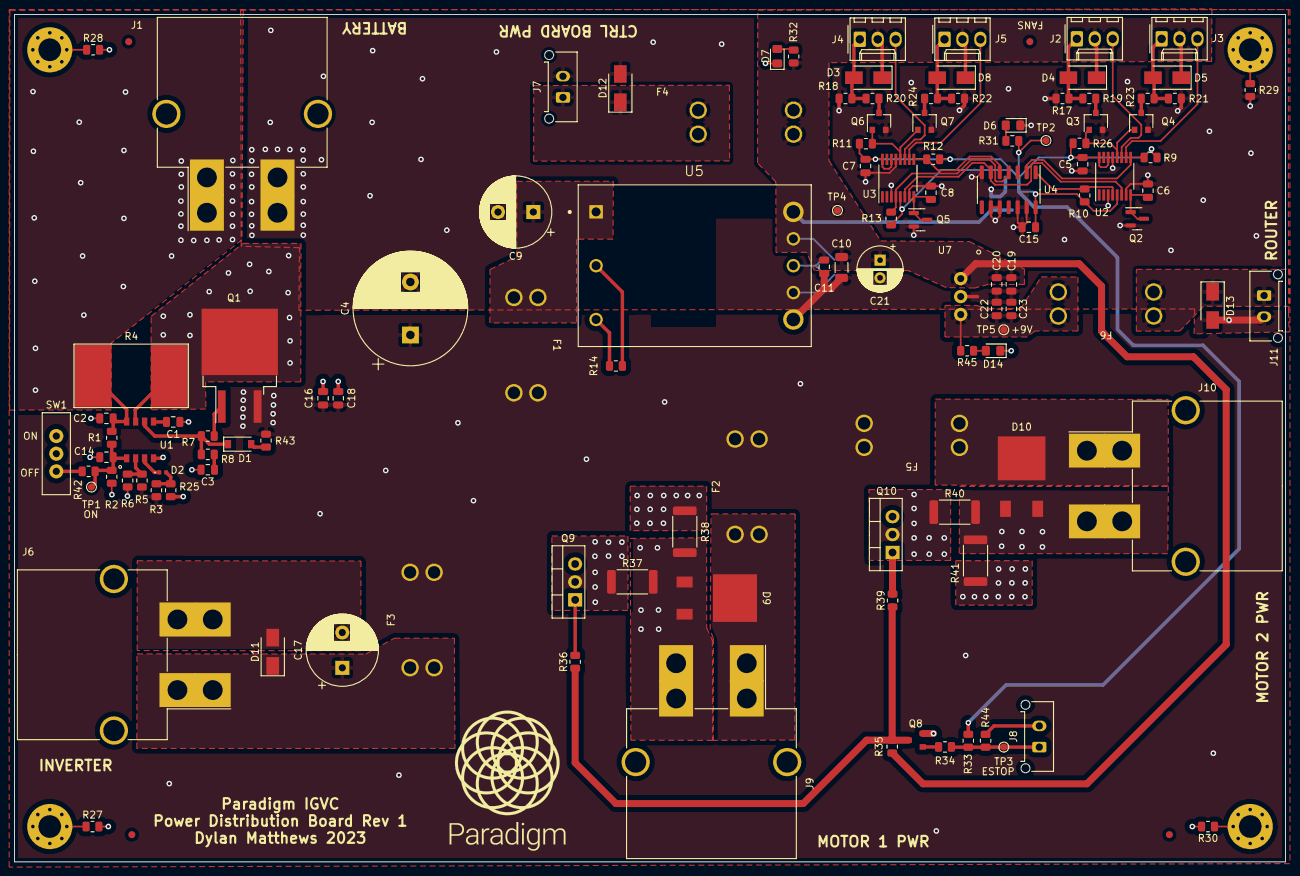
[picture p29: board PowerDistributionBoard.kicad_pcb from above]

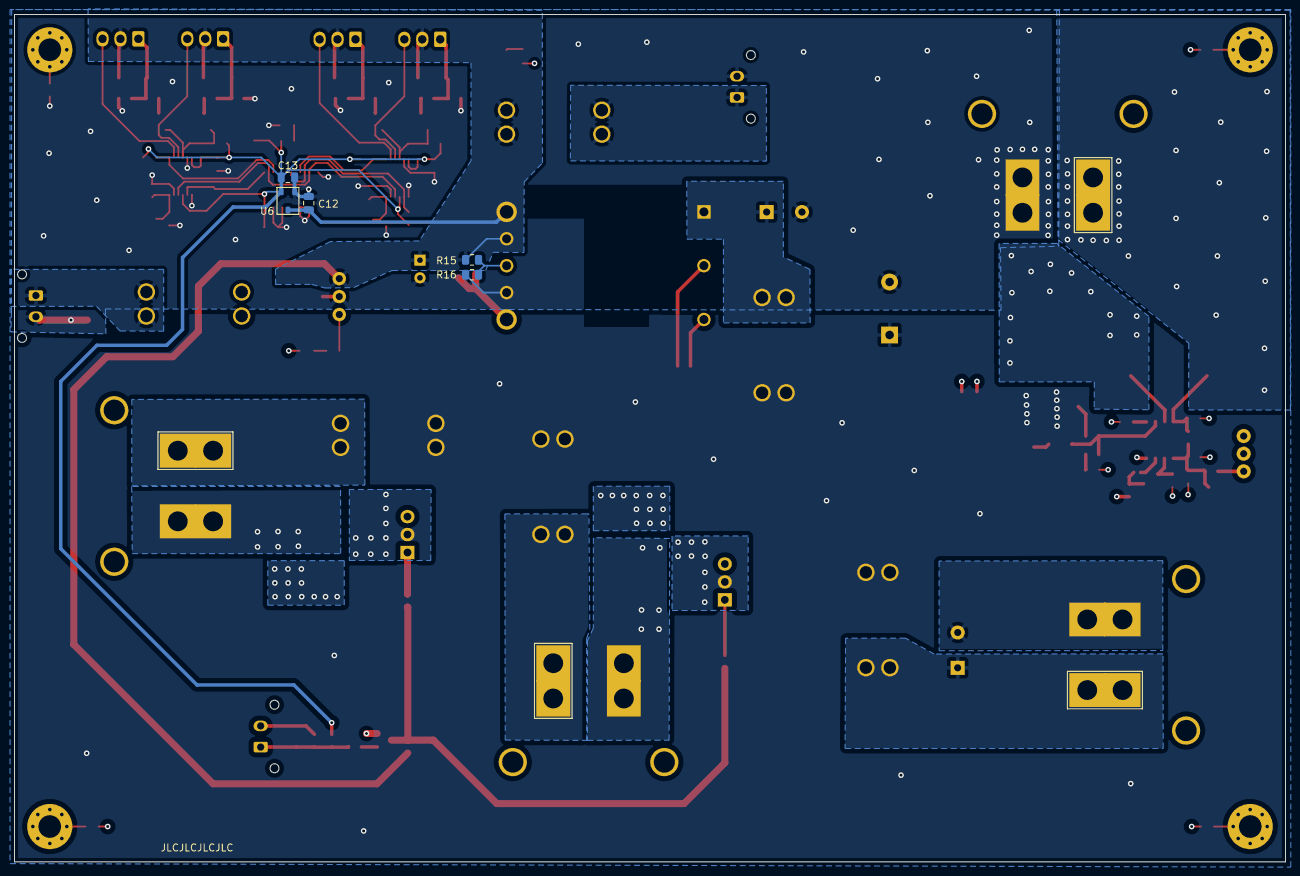
[picture p30: board PowerDistributionBoard.kicad_pcb from below]

Board: 4 copper layers, 180.0 x 120.0 mm, 130 parts (5 on the bottom side), 62 nets.
