ParadigmEngineering/igvc-2023-hardware/hardware/EStopTX/EStopTX/EStopTX.kicad_pcb

## KiCad design hardware/EStopTX/EStopTX/EStopTX.kicad_pcb (2023-04-24)

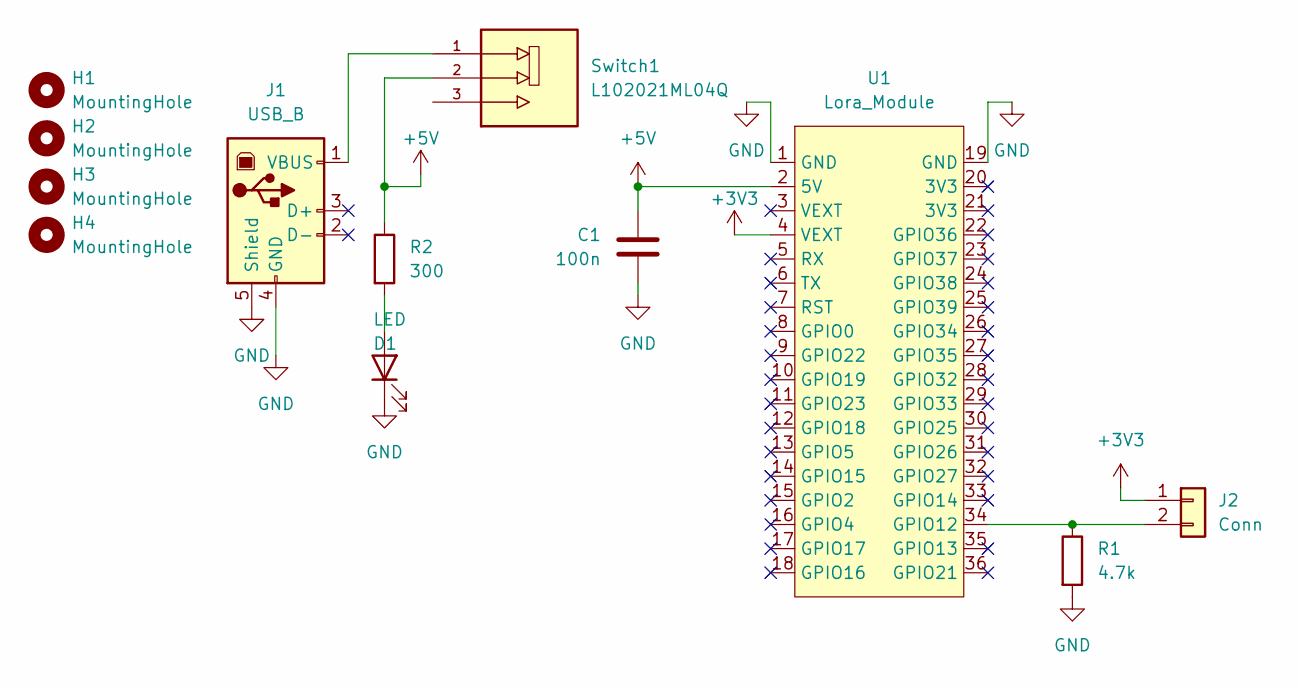
[picture p31: schematic EStopTX.kicad_sch]

Parts:
C1: 100n; C_Disc_D3.8mm_W2.6mm_P2.50mm; Digikey BC1084CT-ND
D1: LED; LED_D5.0mm
H1, H2, H3, H4: MountingHole; MountingHole_3.2mm_M3_Pad_Via
J1: USB_B; USB_B_OST_USB-B1HSxx_Horizontal
J2: Conn; Molex_Micro-Fit_3.0_43650-0200_1x02_P3.00mm_Horizontal
R1: 4.7k; R_Axial_DIN0207_L6.3mm_D2.5mm_P10.16mm_Horizontal
R2: 300; R_Axial_DIN0207_L6.3mm_D2.5mm_P10.16mm_Horizontal
Switch1: L102021ML04Q; SW_L102021ML04Q; Digikey CKC5102-ND
U1: Lora_Module

Connections:
+3V3: J2.1, U1.4 (VEXT)
+5V: C1.2, R2.1, Switch1.2, U1.2 (5V)
GND: C1.1, D1.1 (K), J1.4 (GND), J1.5 (Shield), R1.2, U1.1 (GND), U1.19 (GND)
unnamed: D1.2 (A), R2.2
unnamed: J1.1 (VBUS), Switch1.1
unnamed: J2.2, R1.1, U1.34 (GPIO12)

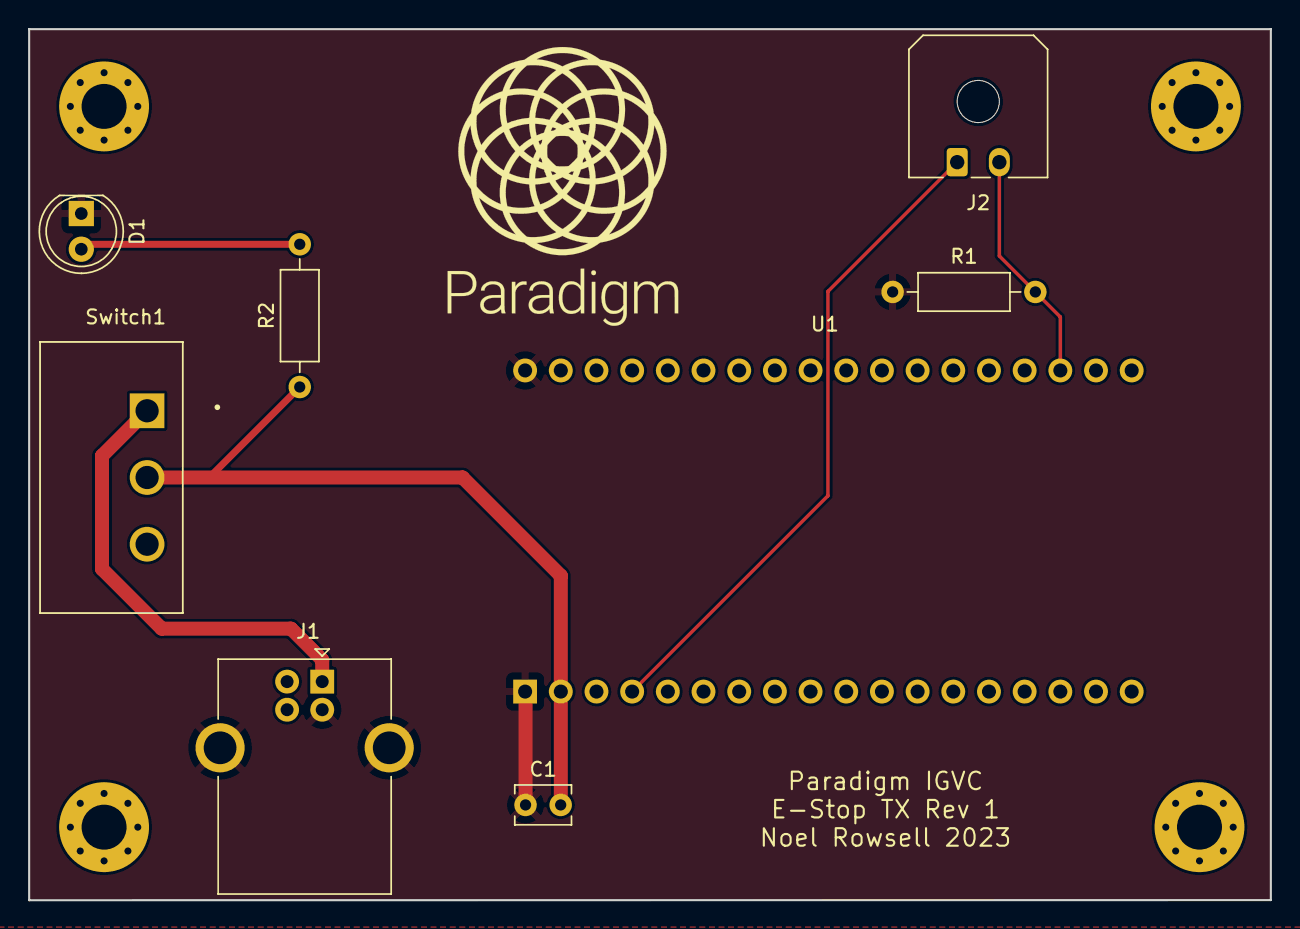
[picture p32: board EStopTX.kicad_pcb from above]

Board: 2 copper layers, 88.4 x 62.0 mm, 12 parts (0 on the bottom side), 6 nets.
