ParadigmEngineering/igvc-2023-hardware/(commit log)

2023-01-02 PDB initial commit
    [PowerDistributionBoard.kicad_pcb, PowerDistributionBoard.kicad_sch]
2023-01-04 Fan Control
    [MAX6643LBBAEET.step, PowerDistributionBoard.kicad_sch]
2023-01-26 Add 12V DC-DC and Estop Relays
    [PowerDistributionBoard.kicad_sch]
2023-01-26 Added Resistor Options on Fans
    [PowerDistributionBoard.kicad_sch]
2023-01-27 Add 3v3 LDO and Some Test Points
    [PowerDistributionBoard.kicad_sch]
2023-01-29 Small stuff
    [PowerDistributionBoard.kicad_sch]
2023-02-03 Add footprints and start layout on PDB, start control board schematic
    [428202223--3DModel-STEP-390490.STEP, 428202224.stp, 436500201_m.stp, 54602-908LFc.stp, B3SL-1022P--3DModel-STEP-1.STEP, ControlBoard.csv, ControlBoard.kicad_pcb, ControlBoard.kicad_sch]
2023-02-05 Layout Attempt 1
    [0679L1000-05.STEP, 436500200--3DModel-STEP-390490.STEP, EG1218--3DModel-STEP-520916.STEP, PowerDistributionBoard.kicad_pcb]
2023-02-15 PDB Routing First Pass
    [PowerDistributionBoard.kicad_pcb, PowerDistributionBoard.kicad_sch]
2023-02-15 Added step
    [PowerDistributionBoard.kicad_pcb]
2023-02-21 Estop Stuff
    [ControlBoard.kicad_sch]
2023-02-22 More Estop Work
    [ControlBoard.kicad_sch]
2023-02-23 PDB Review
    Added a few grounding vias to pads.
    [PowerDistributionBoard.kicad_pcb]
2023-02-24 Updating libraries
    Updated libraries. need to finish making changes to schematic.
2023-02-25 begin adding ESP32 stuff
    [ControlBoard.kicad_sch]
2023-02-25 Fix Battery Connector, FET Footprint
    [428204223.stp, 436500215.stp, PowerDistributionBoard.kicad_pcb, PowerDistributionBoard.kicad_sch]
2023-02-25 Small Changes
    [ControlBoard.kicad_pcb, ControlBoard.kicad_sch, PowerDistributionBoard.csv, PowerDistributionBoard.kicad_pcb, PowerDistributionBoard.kicad_sch]
2023-02-26 Revert "Pushing current status of control board"
    This reverts commit 294db83ea49ed79939e01bc2aaba512b205aee08, reversing
    changes made to 02a1c7b732454ead7e64c67e54126222b2bb5f3d.
    [428204223.stp, 436500215.stp, ControlBoard.kicad_pcb, ControlBoard.kicad_sch, PowerDistributionBoard.csv, PowerDistributionBoard.kicad_pcb, PowerDistributionBoard.kicad_sch]
2023-02-26 Revert "Revert "Pushing current status of control board""
    This reverts commit 0a3f5a1237bc2ff3169470f75d528978fa5c2770.
    [428204223.stp, 436500215.stp, ControlBoard.kicad_pcb, ControlBoard.kicad_sch, PowerDistributionBoard.csv, PowerDistributionBoard.kicad_pcb, PowerDistributionBoard.kicad_sch]
2023-02-26 Revert "Revert "Revert "Pushing current status of control board"""
    This reverts commit d2dbbc2e3509cd4690ee25a171fb3cea29603b1d.
    [428204223.stp, 436500215.stp, ControlBoard.kicad_pcb, ControlBoard.kicad_sch, PowerDistributionBoard.csv, PowerDistributionBoard.kicad_pcb, PowerDistributionBoard.kicad_sch]
2023-03-01 More work on control board
    [ControlBoard.kicad_sch]
2023-03-08 ESP Fixes, Add Motor Controller Interface
    [ControlBoard.kicad_sch]
2023-03-09 Add bypass for relay control BJT
    [PowerDistributionBoard.kicad_pcb, PowerDistributionBoard.kicad_sch]
2023-03-13 Motor Control with ESP/Estop
    [436500215.stp, ControlBoard.kicad_sch, PowerDistributionBoard.kicad_pcb]
2023-03-15 Finish (?) micro stuff, define components, add UART header
    [ControlBoard.kicad_sch]
2023-03-17 Control Board Power Changes
    [ControlBoard.kicad_sch]
2023-03-17 Add note
    [ControlBoard.kicad_sch]
2023-03-18 Fix Regulators, Change LORA Module Supply
    [ControlBoard.kicad_sch]
2023-03-18 Starting Control Board Layout
    [ControlBoard.kicad_pcb, ControlBoard.kicad_sch]
2023-03-19 More Layout
    [ControlBoard.kicad_pcb, ControlBoard.kicad_sch]
2023-03-20 Start Control Board Routing
    [ControlBoard.kicad_pcb, ControlBoard.kicad_sch]
2023-03-21 Motor Controller IO Fixes
    [ControlBoard.kicad_sch]
2023-03-22 Motor control stuff
    [ControlBoard.kicad_pcb, ControlBoard.kicad_sch]
2023-03-23 Control Board Routing Work
    [ControlBoard.kicad_pcb, ControlBoard.kicad_sch]
2023-03-24 Routing Work
    [1050170001.stp, 436500200--3DModel-STEP-390490.STEP, 436501000.stp, ControlBoard.kicad_pcb, PW0016A.stp]
2023-03-25 More Control Board Routing Stuff
    [74LVC1G97W6-7.STEP, ControlBoard.kicad_pcb, ESP32-S3-WROOM-1U--3DModel-STEP-56544.STEP, LD1086DT33TR.STEP, PowerDistributionBoard.kicad_pcb, PowerDistributionBoard.kicad_sch, SOT223-5_DIO.step]
2023-03-26 JLCPCB Part #'s added and footprints verified
    Checked footprints of LDOs and ICs on the board with data sheets
    [ControlBoard.kicad_sch]
2023-03-27 Fix ESP Part Number
    [ControlBoard.kicad_sch]
2023-03-28 Fix Pull-ups on Level Shifters
    [ControlBoard.kicad_sch]
2023-03-31 Start Review Fixes
    [ControlBoard.kicad_sch]
2023-04-01 Schematic Fixes: IO Translators, Safety Light FETs
    [ControlBoard.kicad_sch]
2023-04-04 Fixing the things
    [ControlBoard.kicad_sch]
2023-04-04 EStop TX Initial Commit
    [EStopTX.kicad_pcb, EStopTX.kicad_sch, USB-B1HSB6--3DModel-STEP-1 (1).STEP]
2023-04-05 Control Board - Replace LDOs, Fix ESP Strapping Pins, W EStop Voltage Divider
    [ControlBoard.kicad_sch]
2023-04-06 Most control board schematic fixes done
    [ControlBoard.kicad_pcb, ControlBoard.kicad_sch]
2023-04-08 Control Board Rerouting
    [ControlBoard.kicad_pcb, ControlBoard.kicad_sch]
2023-04-08 continue board
    [EStopTX.kicad_pcb]
2023-04-09 maybe done?
    [436500200--3DModel-STEP-390490.STEP, EStopTX.kicad_pcb, EStopTX.kicad_sch]
2023-04-09 Finish Control Board Routing
    [10118194c.stp, 74LVC1G17W5-7.STEP, ControlBoard.kicad_pcb, PW0014A.stp, SOT23_DMN62D0U_DIO.step]
2023-04-09 Control Board Routing Tweaks
    [ControlBoard.kicad_pcb, TRAN_SS8050-G_CIP.step]
2023-04-10 PDB schematic - Add router power, address review comments
    [PowerDistributionBoard.kicad_sch]
2023-04-12 Replace Relays with FETs for Motor Power Switching
    [ControlBoard.kicad_pcb, PowerDistributionBoard.kicad_sch]
2023-04-13 Power Board Changes
    [ControlBoard.kicad_pcb, PowerDistributionBoard.kicad_sch]
2023-04-14 PDB Hot Swap Circuit Changes/Review, Add Flybacks
    [PowerDistributionBoard.kicad_sch]
2023-04-15 Power Board Schematic Revision Done, Fix Lora Symbol and Update Control Board Routing
    [ControlBoard.kicad_pcb, ControlBoard.kicad_sch, PowerDistributionBoard.kicad_sch]
2023-04-16 PDB Layout
    [3557-2--3DModel-STEP-510211.STEP, PowerDistributionBoard.kicad_pcb, PowerDistributionBoard.kicad_sch, R-78B-1.0.step]
2023-04-16 PDB routing V2 first pass
    [577102B00000G.stp, ControlBoard.kicad_pcb, PowerDistributionBoard.kicad_pcb, PowerDistributionBoard.kicad_sch]
2023-04-19 Switch 5V LDO for DC DC
    [ControlBoard.kicad_pcb, ControlBoard.kicad_sch, R-78B-2.0.STEP]
2023-04-20 hopefully done
    [EStopTX.kicad_pcb, EStopTX.kicad_sch, L102021ML04Q--3DModel-STEP-56544.STEP]
2023-04-20 Estop review
    [EStopTX.kicad_pcb, EStopTX.kicad_sch]
2023-04-21 Last things
    [ControlBoard.kicad_pcb, ControlBoard.kicad_sch, PowerDistributionBoard.kicad_pcb, PowerDistributionBoard.kicad_sch, SO-8_S_LIT.step]
2023-04-21 PDB Assembly PNs
    [PowerDistributionBoard.kicad_sch]
2023-04-23 Finish adding assembly PNs
    [ControlBoard.kicad_pcb, ControlBoard.kicad_sch, PowerDistributionBoard.kicad_pcb, PowerDistributionBoard.kicad_sch]
2023-04-24 Build Files
    [ControlBoard-B_Cu.gbl, ControlBoard-B_Mask.gbs, ControlBoard-B_Paste.gbp, ControlBoard-B_Silkscreen.gbo, ControlBoard-Edge_Cuts.gm1, ControlBoard-F_Cu.gtl, ControlBoard-F_Mask.gts, ControlBoard-F_Paste.gtp]
2023-04-26 Control Board Silk Update
    [ControlBoard.kicad_pcb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]
2023-05-10 Hello World project for esp32-s3 arduino framework
2023-05-17 Driver implementations work in progress
2023-05-19 Polish PWM forward and reverse control, validation TBD
    [fsm.cpp, fsm.h, linear_interpolate.cpp, main.cpp, pwm.cpp, pwm.h, twai.cpp, twai_msg_defs.h]
2023-05-28 Current validation work in progress
2023-06-05 Motor controller alarm fix (?)
    [main.cpp]
