ParadigmEngineering/igvc-2023-hardware/(notices)

Notices in the files:
hardware/EStopTX/EStopTX/Parts/3d models/A11AH.stp:
author */ ('License CC BY-ND 4.0'),
